pjjefferies/Balance_Bot/README.md

# Balance_Bots
 Balance Bot Development
 
 TBD - No really, TBD
