pjjefferies/Balance_Bot/Electronics/Balance Bot Electrical Connection (RP3 based).xlsx

Sheet: Matrix
Balance Bot Electrical Connections
 |  |  |  |  |  |  |  |  |  |  |  |  |  |  |  |  |  |  |  |  |  |  |  |  |  |  |  |  |  |  |  |  |  |  |  |  |  |  |  |  |  |  |  |  |  |  |  |  |  |  |  |  |  |  |  |  |  | M1A (OUT) | M1B (OUT)
Cable Asm. GND | Component | Compact Rechargeable Power Bank (1) | 18650 x 2 Battery Cells, Switched (2) |  | Raspberry Pi (3) |  |  |  |  |  |  |  |  |  |  |  |  |  |  |  |  |  |  |  |  |  |  | Regulator, DROK Mini Voltage Reducer DC 4.5-24 V Step Down Converter Board 3 A - #1 (4) |  |  |  | Regulator, DROK Mini Voltage Reducer DC 4.5-24 V Step Down Converter Board 3 A - #1 (5) |  |  |  | Middle Shelf +3.3 Volt Rail (17) |  |  |  |  |  | Middle Shelf GND Rail (18) |  |  |  |  |  |  |  |  |  | MDD3A Motor Controller - Wheels (6)
+3.3 V +5 V | Functional Pin | Power for Pi | +7.4 Volt | GND | +3.3 V | +5 V | Ground | GPIO14 (TXD) | Ground | USB-C | GPIO2 SDA PC | GPIO3 SDL PC | GPIO4 | GPIO17 | GPIO27 | GPIO22 | GPIO5 | GPIO6 | GPIO13 | GPIO19 | GPIO26 | GPIO21 | GPIO20 | GPIO16 | GPIO12 | GPIO25 | GPIO24 | Output + | Common Negative | Input + | Enable Port | Output + | Common Negative | Input + | Enable Port | N/A | N/A | N/A | N/A | N/A | N/A | N/A | N/A | N/A | N/A | N/A | N/A | N/A | N/A | N/A | N/A | VB+ | VB- | M1A (OUT) | M1B (OUT) | M2A (OUT) | M2B (OUT) | M1A (IN) | M1B (IN)
+7.4 V +6 V | Physical Pin | N/A | 1 | 2 | 1 | 4 | 6 | 8 | 9 | N/A | 3 | 5 | 7 | 11 | 13 | 15 | 29 | 31 | 33 | 35 | 37 | 40 | 38 | 36 | 32 | 22 | 18 | 1 | 2 | 3 | 4 | 1 | 2 | 3 | 4 | 1 | 2 | 3 | 4 | 5 | 6 | 1 | 2 | 3 | 4 | 5 | 6 | 7 | 8 | 9 | 10 | Green Left | Green Right | Black Left Left | Black Left Right | Black Right Left | Black Right Right | 1 | 2
Signals Out Signals In | Connector Type | USB-C | Bare Wire | Bare Wire | □.64 mm Pin | □.64 mm Pin | □.64 mm Pin | □.64 mm Pin | □.64 mm Pin | USB-C | □.64 mm Pin | □.64 mm Pin | □.64 mm Pin | □.64 mm Pin | □.64 mm Pin | □.64 mm Pin | □.64 mm Pin | □.64 mm Pin | □.64 mm Pin | □.64 mm Pin | □.64 mm Pin | □.64 mm Pin | □.64 mm Pin | □.64 mm Pin | □.64 mm Pin | □.64 mm Pin | □.64 mm Pin | PCB Hole | PCB Hole | PCB Hole | PCB Hole | PCB Hole | PCB Hole | PCB Hole | PCB Hole | □.64 mm Pin | □.64 mm Pin | □.64 mm Pin | □.64 mm Pin | □.64 mm Pin | □.64 mm Pin | □.64 mm Pin | □.64 mm Pin | □.64 mm Pin | □.64 mm Pin | □.64 mm Pin | □.64 mm Pin | □.64 mm Pin | □.64 mm Pin | □.64 mm Pin | □.64 mm Pin |  |  |  |  |  |  | □.64 mm Pin | □.64 mm Pin
Priorities 1: For initial movement 4. Arm Movement 2: For Wheel Sensor 5. Arm Sensors 3. Sensor | Priority | Power for Electronics | Power for Motors | Power for Motors | Power for 5 Sensors | Power for Motor Power Relay | Ground for Motor Power Relay | Signal to Motor Power Relay | Ground for All | Power In | 9DOF Sensor | 9DOF Sensor | Left Wheel Fwd. | Left Wheel Rwd. | Right Wheel Fwd. | Right Wheel Rwd. | Left Arm Fwd. | Left Arm Rwd. | Right Arm Fwd. | Right Arm Rwd. | Left Wheel Encoder | Right Wheel Encoder | Left Arm Encoder | Right Arm Encoder | Enable Power to Wheels | Enable Power to Arms | Reset Sensor | +6 V Out to Wheel Motor Controller | GND from Mid. Shelf GND Rail | 7.4 V In from Batteries | Enable from Pi | +6 V Out to Wheel Motor Controller | GND from Mid. Shelf GND Rail | 7.4 V In from Batteries | Enable from Pi | +3.3 V From Raspbery Pi | 3.3 V to Left Arm Sensor | 3.3 V to Right Arm Sensor | +3.3 V to Lower Shelf +3.3 Volt Rail | +3.3 V Empty | +3.3 V Empty | Gnd to Pi | Gnd to 7.4 V Battery Pack | Gnd to Wheel Voltage Reg. | Gnd to Arm Voltage Reg. | Gnd to Wheel Motor Controler | Gnd to Arm Motor Controler | GND to Left Arm Sensor | GND to Right Arm Sensor | Gnd to Lower Shelf Gnd Rail | Gnd - Empty | +6 V in from Reg. | GND to Mid. Shelf Rail | +V Out to Left Wheel Motor Fwd. | +V Out to Left Wheel Motor Rwd. | +V Out to Right Wheel Motor Fwd. | +V Out to Right Wheel Motor Rwd. | +V Level in For Left Wheel Motor Speed Fwd. | +V Level in For Left Wheel Motor Speed Rwd.
~~USB Cord + USB Cord with Switch~~ | 1A
~~2-Batt. Pack to Both Volt. Reg. (+7.4 V)~~ | 1A / 4
~~2-Batt. Pack to Middle Shelf GND Rail (GND)~~ | 1A / 4
RaspPi +3.3 V to +3.3 V Rail | 1A
RaspPI GND to Middle Shelf GND Rail | 1A
RaspPI Signal to Left Wheel FWD | 1A
RaspPI Signal to Left Wheel RWD | 1A
RaspPi Signal to Enable Wheel Motors | 1A
3.3 V from Middle Shelf Rail to Lower Shelf Rail | 1A
~~+6 V from Reg. (4) to Wheel Motor Controller~~ | 1A
~~GND from Middle Shelf Rail to Wheel Voltage Regulator~~ | 1A
~~Middle Shelf GND Rail to Wheel Motor Controller~~ | 1A
Middle Shelf GND Rail to Lower Shelf GND Rail | 1A
~~Wheel Motor Controller to Left Wheel Motor - FWD~~ | 1A
~~Wheel Motor Controller to Left Wheel Motor - RWD~~ | 1A
RaspPI Signal to Right Wheel FWD | 1B
RaspPI Signal to Right Wheel RWD | 1B
~~Wheel Motor Controller to Right Wheel Motor - FWD~~ | 1B
~~Wheel Motor Controller to Right Wheel Motor - RWD~~ | 1B
Left Wheel Encoder to RaspPi | 2
Right Wheel Encoder to RaspPi | 2
+3.3 V Lower Shelf Rail to Left Wheel Rotation Sensor | 2
GND Lower Shelf Rail to Left Wheel Rotation Sensor | 2
+3.3 V Lower Shelf Rail to Right Wheel Rotation Sensor | 2
GND Lower Shelf Rail to Right Wheel Rotation Sensor | 2
RaspPi i2C SDA to BNO055 Sensor | 3
RaspPi i2C SDL/SCL to BNO055 Sensor | 3
RaspPi Signal to BNO055 Sensor Reset | 3
+3.3 V Lower Shelf Rail to BNO055 Sensor | 3
GND Lower Shelf Rail to BNO055 Sensor | 3
RaspPI Signal to Left Arm FWD | 4
RaspPI Signal to Left Arm RWD | 4
RaspPI Signal to Right Arm FWD | 4
RaspPI Signal to Right Arm RWD | 4
RaspPi Signal to Enable Arm Motors | 4
+6 V from Reg. (5) to Arm Motor Controller | 4
GND from Middle Shelf Rail to Arm Voltage Regulator | 4
Middle Shelf GND Rail to Arm Motor Controller | 4
Middle Shelf GND Rail to Right Arm Sensor | 4
Arm Motor Controller to Left Arm Motor - FWD | 4
Arm Motor Controller to Left Arm Motor - RWD | 4
Arm Motor Controller to Right Arm Motor - FWD | 4
Arm Motor Controller to Right Arm Motor - RWD | 4
Left Arm Encoder to RaspPi | 5
Right Arm Encoder to RaspPi | 5
+3.3 V from Middle Shelf Rail to Left Arm Sensor | 5
+3.3 V from Middle Shelf Rail to Right Arm Sensor | 5
Middle Shelf GND Rail to Left Arm Sensor | 5

Sheet: Modules-Pinouts
Wiring instructions:
1, VCC positive power supply 3.3-5V
2, GND power supply is negative
3, DO TTL switching signal output
4, AO this module does not work

Sheet: Wire Types
Voltage (V) | Voltage Drop (%) | Voltage Drop (V) / Length | Current (A) | Length (mm) | Length (ft) | Voltage Drop / 100 ft | AWG
7.4 | 1% | 0.074 | 3 | 200 | 0.656167979 | 11.2776 | 22
6 | 1% | 0.06 | 1.5 | 200 | 0.656167979 | 9.144 | 24
3.3 | 1% | 1% | 1 | 200 | 0.656167979 | 1.524 | 18
3.3 | 1% | 1% | 0.120 | 200 | 0.656167979 | 1.524 | 28
 |  |  |  |  |  |  |  |  | Wrapped Wire I have in Red, Green, Black: 20 AWG (7/28-7 strands of 28 gauge wire)
 |  |  |  |  |  |  |  |  | Cables with Connectors for Header Pins: 28 AWG (7/36)
AWG Gauge | Solid Dia. (mm) | Solid Area (mm^2) |  |  | 7 Strands Area (mm^2) |  |  | 7 Strands Area (mm^2) | Cables with Male Pins for Breadboard Wiring: 30 or 28 AWG (7/36 or 7/38)
42 | 0.06 | 0.003
40 | 0.08 | 0.005 |  |  |  |  |  | 0.03507252965
38 | 0.10 | 0.008 |  |  |  |  |  | 0.05576750658
36 | 0.13 | 0.013 |  |  |  |  |  | 0.08867380884
34 | 0.16 | 0.020
32 | 0.20 | 0.032
30 | 0.25 | 0.051
28 | 0.32 | 0.081 |  |  |  |  |  | 0.5668287995
26 | 0.40 | 0.129
24 | 0.51 | 0.205
22 | 0.64 | 0.326
20 | 0.81 | 0.518
18 | 1.02 | 0.823
16 | 1.29 | 1.309
14 | 1.63 | 2.081
12 | 2.05 | 3.309

Sheet: Matrix-old
Balance Bot Electrical Connections
 |  |  |  | Component | Compact Rechargeable Power Bank (1) | 18650 x 2 Battery Cells, Switched (2) |  | Raspberry Pi (3) |  |  |  |  |  |  |  |  |  |  |  |  |  |  |  |  | Regulator, DROK Mini Voltage Reducer DC 4.5-24 V Step Down Converter Board 3 A - #1 (4) |  |  |  | Regulator, DROK Mini Voltage Reducer DC 4.5-24 V Step Down Converter Board 3 A - #1 (5) |  |  |  | Middle Shelf +3.3 Volt Rail (17) |  |  |  |  |  | Middle Shelf GND Rail (18) |  |  |  |  |  |  |  |  |  | MDD3A Motor Controller - Wheels (6) |  |  |  |  |  |  |  |  |  | MDD3A Motor Controller - Arms (7)
 | · Short Cable with Switch · X mm USB-C Cable |  |  | Functional Pin | Power for Pi | +7.4 Volt | GND | +3.3 V | Ground | USB-C | GPIO4 | GPIO17 | GPIO27 | GPIO22 | GPIO5 | GPIO6 | GPIO13 | GPIO19 | GPIO26 | GPIO21 | GPIO20 | GPIO16 | GPIO12 | GPIO25 | Output + | Common Negative | Input + | Enable Port | Output + | Common Negative | Input + | Enable Port | N/A | N/A | N/A | N/A | N/A | N/A | N/A | N/A | N/A | N/A | N/A | N/A | N/A | N/A | N/A | N/A | VB+ | VB- | M1A-IN | M1B-IN | M2A-IN | M2B-IN | M1A-OUT | M1B-OUT | M2A-OUT | M2B-OUT | VB+
 |  |  |  | Physical Pin | N/A | 1 | 2 | 1 | 9 | N/A | 7 | 11 | 13 | 15 | 29 | 31 | 33 | 35 | 37 | 40 | 38 | 36 | 32 | 22 | 1 | 2 | 3 | 4 | 1 | 2 | 3 | 4 | 1 | 2 | 3 | 4 | 5 | 6 | 1 | 2 | 3 | 4 | 5 | 6 | 7 | 8 | 9 | 10 | Green Left | Green Right | Black Left Left | Black Left Right | Black Right Left | Black Right Right | 1 | 2 | 5 | 6 | Green Left
 |  |  |  | Connector Type | USB-C | Bare Wire | Bare Wire | □.64 mm Pin | □.64 mm Pin | USB-C | □.64 mm Pin | □.64 mm Pin | □.64 mm Pin | □.64 mm Pin | □.64 mm Pin | □.64 mm Pin | □.64 mm Pin | □.64 mm Pin | □.64 mm Pin | □.64 mm Pin | □.64 mm Pin | □.64 mm Pin | □.64 mm Pin | □.64 mm Pin | PCB Hole | PCB Hole | PCB Hole | PCB Hole | PCB Hole | PCB Hole | PCB Hole | PCB Hole | □.64 mm Pin | □.64 mm Pin | □.64 mm Pin | □.64 mm Pin | □.64 mm Pin | □.64 mm Pin | □.64 mm Pin | □.64 mm Pin | □.64 mm Pin | □.64 mm Pin | □.64 mm Pin | □.64 mm Pin | □.64 mm Pin | □.64 mm Pin | □.64 mm Pin | □.64 mm Pin |  |  |  |  |  |  | □.64 mm Pin | □.64 mm Pin | □.64 mm Pin | □.64 mm Pin
Component | Functional Pin | Physical Pin | Connector Type | Function | Power for Electronics | Power for Motors | Power for Motors | Power for 5 Sensors | Ground for All | Power In | Left Wheel Fwd. | Left Wheel Rwd. | Right Wheel Fwd. | Right Wheel Rwd. | Left Arm Fwd. | Left Arm Rwd. | Right Arm Fwd. | Right Arm Rwd. | Left Wheel Encoder | Right Wheel Encoder | Left Arm Encoder | Right Arm Encoder | Enable Power to Wheels | Enable Power to Arms | +6 V Out to Wheel Motor Controller | GND from Mid. Shelf GND Rail | 7.4 V In from Batteries | Enable from Pi | +6 V Out to Wheel Motor Controller | GND from Mid. Shelf GND Rail | 7.4 V In from Batteries | Enable from Pi | 3.3 V to Left Arm Sensor | 3.3 V to Right Arm Sensor | +3.3 V to Lower Shelf +3.3 Volt Rail | +3.3 V Empty | +3.3 V Empty | +3.3 V Empty | Gnd to Pi | Gnd to 7.4 V Battery Pack | Gnd to Wheel Voltage Reg. | Gnd to Arm Voltage Reg. | Gnd to Wheel Motor Controler | Gnd to Arm Motor Controler | GND to Left Arm Sensor | GND to Right Arm Sensor | Gnd to Lower Shelf Gnd Rail | Gnd - Empty | +6 V in from Reg. | GND to Mid. Shelf Rail | +V Out to Left Wheel Motor Fwd. | +V Out to Left Wheel Motor Rwd. | +V Out to Right Wheel Motor Fwd. | +V Out to Right Wheel Motor Rwd. | +V Level in For Left Wheel Motor Speed Fwd. | +V Level in For Left Wheel Motor Speed Rwd. | +V Level in For Right Wheel Motor Speed Fwd. | +V Level in For Right Wheel Motor Speed Rwd. | +6 V in from Reg.
Compact Rechargeable Power Bank (1) | Power for Pi | N/A | USB-C | Power for Electronics
18650 x 2 Battery Cells, Switched (2) | Power for Pi | 1 | Bare Wire | Power for Motors
 |  | 2 | Bare Wire | Power for Motors
Raspberry Pi (3) | +3.3 V | 1 | □.64 mm Pin | Power for 5 Sensors
 | Ground | 9 | □.64 mm Pin | Ground for All
 | USB-C | N/A | USB-C | Power In | ~100 mm USB-C M-F Cord With Switch X mm USB-C M-M Cord
 | GPIO4 | 7 | □.64 mm Pin | Left Wheel Fwd.
 | GPIO17 | 11 | □.64 mm Pin | Left Wheel Rwd.
 | GPIO27 | 13 | □.64 mm Pin | Right Wheel Fwd.
 | GPIO22 | 15 | □.64 mm Pin | Right Wheel Rwd.
 | GPIO5 | 29 | □.64 mm Pin | Left Arm Fwd.
 | GPIO6 | 31 | □.64 mm Pin | Left Arm Rwd.
 | GPIO13 | 33 | □.64 mm Pin | Right Arm Fwd.
 | GPIO19 | 35 | □.64 mm Pin | Right Arm Rwd.
 | GPIO26 | 37 | □.64 mm Pin | Left Wheel Encoder
 | GPIO21 | 40 | □.64 mm Pin | Right Wheel Encoder
 | GPIO20 | 38 | □.64 mm Pin | Left Arm Encoder
 | GPIO16 | 36 | □.64 mm Pin | Right Arm Encoder
 | GPIO12 | 32 | □.64 mm Pin | Enable Power to Wheels
 | GPIO25 | 22 | □.64 mm Pin | Enable Power to Arms
Regulator, DROK Mini Voltage Reducer DC 4.5-24 V Step Down Converter Board 3 A - #1 (4) | Output + | 1 | PCB Hole | +6 V Out to Wheel Motor Controller
 | Common Negative | 2 | PCB Hole | GND from Mid. Shelf GND Rail
 | Input + | 3 | PCB Hole | 7.4 V In from Batteries |  | 20 AWG, Red, length: ~200 mm
 | Enable Port | 4 | PCB Hole | Enable from Pi
Regulator, DROK Mini Voltage Reducer DC 4.5-24 V Step Down Converter Board 3 A - #1 (5) | Output + | 1 | PCB Hole | +6 V Out to Wheel Motor Controller
 | Common Negative | 2 | PCB Hole | GND from Mid. Shelf GND Rail
 | Input + | 3 | PCB Hole | 7.4 V In from Batteries |  | 20 AWG, Red, Short jumper from 1st Reg.
 | Enable Port | 4 | PCB Hole | Enable from Pi
Middle Shelf +3.3 Volt Rail (17) | N/A | 1 | □.64 mm Pin | 3.3 V to Left Arm Sensor
 | N/A | 2 | □.64 mm Pin | 3.3 V to Right Arm Sensor
 | N/A | 3 | □.64 mm Pin | +3.3 V to Lower Shelf +3.3 Volt Rail
 | N/A | 4 | □.64 mm Pin | +3.3 V from Raspberry Pi |  |  |  | 20 AWG,
 | N/A | 5 | □.64 mm Pin | +3.3 V Empty
 | N/A | 6 | □.64 mm Pin | +3.3 V Empty
Middle Shelf GND Rail (18) | N/A | 1 | □.64 mm Pin | Gnd to Pi |  |  |  |  | 20 AWG, Black,
 | N/A | 2 | □.64 mm Pin | Gnd to 7.4 V Battery Pack |  |  | 20 AWG, Black, ~200 mm
 | N/A | 3 | □.64 mm Pin | Gnd to Wheel Voltage Reg.
 | N/A | 4 | □.64 mm Pin | Gnd to Arm Voltage Reg.
 | N/A | 5 | □.64 mm Pin | Gnd to Wheel Motor Controler
 | N/A | 6 | □.64 mm Pin | Gnd to Arm Motor Controler
 | N/A | 7 | □.64 mm Pin | GND to Left Arm Sensor
 | N/A | 8 | □.64 mm Pin | GND to Right Arm Sensor
 | N/A | 9 | □.64 mm Pin | Gnd to Lower Shelf Gnd Rail
 | N/A | 10 | □.64 mm Pin | Gnd - Empty
MDD3A Motor Controller - Wheels (6) | VB+ | Green Left |  | +6 V in from Reg.
 | VB- | Green Right |  | GND to Mid. Shelf Rail
 | M1A-IN | Black Left Left |  | +V Out to Left Wheel Motor Fwd.
 | M1B-IN | Black Left Right |  | +V Out to Left Wheel Motor Rwd.
 | M2A-IN | Black Right Left |  | +V Out to Right Wheel Motor Fwd.
 | M2B-IN | Black Right Right |  | +V Out to Right Wheel Motor Rwd.
 | M1A-OUT | 1 | □.64 mm Pin | +V Level in For Left Wheel Motor Speed Fwd. |  |  |  |  |  |  | Something here
 | M1B-OUT | 2 | □.64 mm Pin | +V Level in For Left Wheel Motor Speed Rwd. |  |  |  |  |  |  |  | Something here
 | M2A-OUT | 5 | □.64 mm Pin | +V Level in For Right Wheel Motor Speed Fwd. |  |  |  |  |  |  |  |  | Something here
 | M2B-OUT | 6 | □.64 mm Pin | +V Level in For Right Wheel Motor Speed Rwd. |  |  |  |  |  |  |  |  |  | Something here
MDD3A Motor Controller - Arms (7) | VB+ | Green Left |  | +6 V in from Reg.
 | VB- | Green Right |  | GND to Mid. Shelf Rail
 | M1A-IN | Black Left Left |  | +V Out to Left Arm Motor Front Up
 | M1B-IN | Black Left Right |  | +V Out to Left Arm Motor Front Down
 | M2A-IN | Black Right Left |  | +V Out to Right Arm Motor Front Up
 | M2B-IN | Black Right Right |  | +V Out to Right Arm Motor Front Down
 | M1A-OUT | 1 | □.64 mm Pin | +V Level in For Left Arm Motor Speed Front Up |  |  |  |  |  |  |  |  |  |  | Something here
 | M1B-OUT | 2 | □.64 mm Pin | +V Level in For Left Arm Motor Speed Front Down |  |  |  |  |  |  |  |  |  |  |  | Something here
 | M2A-OUT | 5 | □.64 mm Pin | +V Level in For Right Arm Motor Speed Front Up |  |  |  |  |  |  |  |  |  |  |  |  | Something here
 | M2B-OUT | 6 | □.64 mm Pin | +V Level in For Right Arm Motor Speed Front Down |  |  |  |  |  |  |  |  |  |  |  |  |  | Something here
Left Arm Motor (10) | Up Front | 1 | Soldier Tab | +Up to 6 V to Lift Arm Up
 | Down Front | 2 | Soldier Tab | +Up to 6 V to Lower Arm Down
Right Arm Motor (11) | Up Front | 1 | Soldier Tab | +Up to 6 V to Lift Arm Up
 | Down Front | 2 | Soldier Tab | +Up to 6 V to Lower Arm Down
Left Arm Rotation Sensor (14) | VCC | 1 | □.64 mm Pin | +3.3-5 V
 | GND | 2 | □.64 mm Pin | GND
 | D0 | 3 | □.64 mm Pin | TTL output
 | A0 | 4 | □.64 mm Pin | No Op.
Left Arm Rotation Sensor (15) | VCC | 1 | □.64 mm Pin | +3.3-5 V
 | GND | 2 | □.64 mm Pin | GND
 | D0 | 3 | □.64 mm Pin | TTL output
 | A0 | 4 | □.64 mm Pin | No Op.
Left Wheel Motor (8) | Up Front | 1 | Soldier Tab | +Up to 6 V to Lift Wheel Up
 | Down Front | 2 | Soldier Tab | +Up to 6 V to Lower Wheel Down
Right Wheel Motor (9) | Up Front | 1 | Soldier Tab | +Up to 6 V to Lift Wheel Up
 | Down Front | 2 | Soldier Tab | +Up to 6 V to Lower Wheel Down
Left Wheel Rotation Sensor (12) | VCC | 1 | □.64 mm Pin | +3.3-5 V
 | GND | 2 | □.64 mm Pin | GND
 | D0 | 3 | □.64 mm Pin | TTL output
 | A0 | 4 | □.64 mm Pin | No Op.
Left Wheel Rotation Sensor (13) | VCC | 1 | □.64 mm Pin | +3.3-5 V
 | GND | 2 | □.64 mm Pin | GND
 | D0 | 3 | □.64 mm Pin | TTL output
 | A0 | 4 | □.64 mm Pin | No Op.
BNO055 Adafruit Board (16) | Vin | 1-1 | PCB Hole | 3.3-5 V In
 | 3vo | 1-2 | PCB Hole | 3.3 V Out (up to 50 mA)
 | GND | 1-3 | PCB Hole | Common Ground
 | SDA | 1-4 | PCB Hole | I2C Data Line
 | SLC | 1-5 | PCB Hole | SLC Data Line
 | RST | 1-6 | PCB Hole | L-H Reset
 | PS0 | 2-1 | PCB Hole | Mode Change
 | PS1 | 2-2 | PCB Hole | Mode Change
 | INT | 2-3 | PCB Hole | Triggered Interrupt
 | ADR | 2-4 | PCB Hole | I2C Address Change
Lower Shelf +3.3 Volt Rail (19) | N/A | 1 | □.64 mm Pin | +3.3 V to Middle Shelf +3.3 Volt Rail
 | N/A | 2 | □.64 mm Pin | 3.3 V to Left Wheel Sensor
 | N/A | 3 | □.64 mm Pin | 3.3 V to Right Wheel Sensor
 | N/A | 4 | □.64 mm Pin | 3.3 V to BNO055 Sensor
 | N/A | 5 | □.64 mm Pin | +3.3 V Empty
 | N/A | 6 | □.64 mm Pin | +3.3 V Empty
 | N/A | 7 | □.64 mm Pin | +3.3 V Empty
 | N/A | 8 | □.64 mm Pin | +3.3 V Empty
Lower Shelf GND Rail (20) | N/A | 1 | □.64 mm Pin | GND from Middle Shelf Gnd Rail
 | N/A | 2 | □.64 mm Pin | GND to Left Wheel Sensor
 | N/A | 3 | □.64 mm Pin | GND to Right Wheel Sensor
 | N/A | 4 | □.64 mm Pin | GND to BNO055 Sensor
 | N/A | 5 | □.64 mm Pin | Gnd - Empty
 | N/A | 6 | □.64 mm Pin | Gnd - Empty
 | N/A | 7 | □.64 mm Pin | Gnd - Empty
 | N/A | 8 | □.64 mm Pin | Gnd - Empty
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
