pjjefferies/Balance_Bot/BOM/BOM, Balance Bot 001.xlsx

Sheet: Balance Bot BOM
 |  |  |  | Indented BOM Report |  |  |  |  |  |  |  | Date: ?
 |  |  |  | [Release]
Line# | Level |  |  | Part Desc | UOM | Drawing Page | Cost Ea. | Cost Ext. | Qty | Est. Qty | Weight (kg) | Ext. Weight
 | 0 |  |  | Robot, Balance Bot, 001 |  | 1
 | 1 |  |  | ASM, LOWER SHELF |  | 6 |  | $0.00 | 1 | 1
 |  | 2 |  | SHELF, LOWER |  | 5 |  | $0.00 | 1 | 1 |  | 0.000
 |  | 2 |  | ASM, BEARING, MOUNT |  | 16 |  | $0.00 | 2 | 2 |  | 0.000
 |  |  | 3 | BLOCK, BEARING SUPPORT |  | 16 |  | $0.00 | 2 | 4 |  | 0.000
 |  |  | 3 | BEARING, 12.7X28.575X7.9875 |  |  |  | $0.00 | 1 | 2 |  | 0.000
 |  |  | 3 | RETAINER, BEARING |  | 16 |  | $0.00 | 2 | 4 |  | 0.000
 |  |  | 3 | SCREW, HEX, M3X16 |  |  |  | $0.00 | 4 | 8 |  | 0.000
 |  |  | 3 | NUT, HEX, M3 |  |  |  | $0.00 | 4 | 8 |  | 0.000
 |  | 2 |  | SHAFT, 0.5 IN, X L |  |  |  | $0.00 | 2 | 2 |  | 0.000
 |  | 2 |  | ENCODER, 25 mm |  |  |  | $0.00 | 2 | 2 |  | 0.000
 |  | 2 |  | WHEEL, TT MOTOR, 65 mm X ? |  |  |  | $0.00 | 2 | 2 |  | 0.000
 |  | 2 |  | BRACKET, MOUNTING, L-SHAPED |  | 15 |  | $0.00 | 4 | 4 |  | 0.000
 |  | 2 |  | MOTOR, TT |  |  |  | $0.00 | 2 | 2 |  | 0.000
 |  | 2 |  | MODULE, IR ENCODER |  |  |  | $0.00 | 2 | 2 |  | 0.000
 |  | 2 |  | MODULE, SENSOR, ADAFRUIT, BN055 |  |  |  | $0.00 | 1 | 1 |  | 0.000
 |  | 2 |  | HEADER, PIN, 1X6 |  |  |  | $0.00 | 1 | 1 |  | 0.000
 |  | 2 |  | STANDOFF, M3X ? |  |  |  | $0.00 | 4 | 4 |  | 0.000
 |  | 2 |  | SCREW, M3X8 |  |  |  | $0.00 | 6 | 6 |  | 0.000
 |  | 2 |  | SCREW,M3X12 |  |  |  |  | 12 | 12
 |  | 2 |  | SCREW,M3X25 |  |  |  |  | 4 | 4
 |  | 2 |  | NUT, HEX, M3 |  |  |  |  | 14 | 14
 | 1 |  |  | ASM, MIDDLE SHELF |  | 7 |  | $0.00 | 1 | 1
 |  | 2 |  | SHELF, MIDDLE |  | 4 |  | $0.00 | 3 | 3 |  | 0.000
 |  | 2 |  | MODULE, MOTOR, XXX |  |  |  | $0.00 | 6 | 6 |  | 0.000
 |  | 2 |  | MODULE, RASPBERRY PI 4, MODEL B |  |  |  | $0.00 | 2 | 2 |  | 0.000
 |  |  | 3 | Main Control Module
 |  |  | 3 | Motor Control Module
 |  |  | 3 | Balance Module
 |  |  | 3 | Forward/Reverse Motion Module
 |  |  | 3 | Turning Module
 |  |  | 3 | Path Navigation Module
 |  |  | 3 | Receive Remote Signal Module
 |  |  | 3 | Display / Message Module
 |  |  | 3 | Object Detection Module
 |  |  | 3 | Mapping Module
 |  |  | 3 | Route Planning Module
 |  | 2 |  | ASM, BEARING, MOUNT |  | 16 |  | $0.00 | 2 | 2 |  | 0.000
 |  |  | 3 | BLOCK, BEARING SUPPORT |  | 16 |  | $0.00 | 2 | 4 |  | 0.000
 |  |  | 3 | BEARING, 12.7X28.575X7.9875 |  |  |  | $0.00 | 1 | 2 |  | 0.000
 |  |  | 3 | RETAINER, BEARING |  | 16 |  | $0.00 | 2 | 4 |  | 0.000
 |  |  | 3 | SCREW, HEX, M3X16 |  |  |  | $0.00 | 4 | 8
 |  |  | 3 | NUT, HEX, M3 |  |  |  | $0.00 | 4 | 8
 |  | 2 |  | ASM, ARM |  | 14 |  | $0.00 | 2 | 2
 |  |  | 3 | AXLE, ARM |  | 14 |  |  | 1 | 2
 |  |  | 3 | ARM |  | 14 |  |  | 1 | 1
 |  | 2 |  | ENCODER, 25 mm |  |  |  |  | 2 | 2
 |  | 2 |  | BRACKET, MOUNTING, L-SHAPED |  | 15 |  |  | 4 | 4
 |  | 2 |  | ENCODER, 25 mm |  |  |  |  | 2 | 2
 |  | 2 |  | MOTOR, TT, 99:1 GEAR RATIO |  |  |  |  | 2 | 2
 |  | 2 |  | MODULE, IR ENCODER |  |  |  |  | 2 | 2
 |  | 2 |  | STANDOFF, M3X ? |  |  |  | $0.00 | 12 | 12 |  | 0.000
 |  | 2 |  | SCREW, M3X8 |  |  |  | $0.00 | 14 | 14 |  | 0.000
 |  | 2 |  | SCREW,M3X12 |  |  |  |  | 20 | 20
 |  | 2 |  | SCREW,M3X25 |  |  |  |  | 4 | 4
 |  | 2 |  | NUT, HEX, M3 |  |  |  |  | 12 | 12
 | 1 |  |  | ASM, TOP SHELF |  | 8 |  | $0.00 | 1 | 1
 |  | 2 |  | SHELF, TOP |  | 2 |  | $0.00 | 1 | 1 |  | 0.000
 |  | 2 |  | BLOCK, LOCATING |  | 15 |  | $0.00 | 2 | 2 |  | 0.000
 |  | 2 |  | MODULE, POWER BANK |  |  |  | $0.00 | 1 | 1 |  | 0.000
 |  | 2 |  | RETAINER, POWER BANK |  | 15 |  | $0.00 | 1 | 1 |  | 0.000
 |  | 2 |  | HOLDER, BATTERY, 2X18650 |  |  |  | $0.00 | 1 | 1 |  | 0.000
 |  | 2 |  | BATTERY, 2X18650 |  |  |  | $0.00 | 2 | 2 |  | 0.000
 |  | 2 |  | SCREW, WOOD, #8x1/2" |  |  |  | $0.00 | 8 | 8 |  | 0.000
 |  | 2 |  | SCREW, FLAT HEAD, #8x6-8 |  |  |  | $0.00 | 4 | 4 |  | 0.000
 |  | 2 |  | NUT, Tee, #8 |  |  |  | $0.00 | 4 | 4 |  | 0.000
 | 1 |  |  | ASM, FRONT COVER |  | 13 |  | $0.00 | 1 | 1 |  | 0.000
 |  | 2 |  | COVER, FRONT |  | 9 |  |  | 1 | 1
 |  | 2 |  | SUPPORT, 9.375 x X 50 |  | 3 |  |  | 2 | 2
 |  | 2 |  | SUPPORT, 19.05 x X 75 |  | 3 |  |  | 4 | 4
 | 1 |  |  | ASM, SIDE COVER |  | 12 |  |  | 2 | 2
 |  | 2 |  | COVER, SIDE |  | 11 |  |  | 1 | 2
 |  | 2 |  | SUPPORT, 19.05 x X 50 |  | 3 |  |  | 4 | 8
 | 1 |  |  | COVER, BACK |  | 10 |  |  | 1 | 1
 | 2 |  |  | HINGES, ? |  |  |  |  | 2 | 2
 | 1 |  |  |  |  |  |  | $0.00 | 2 |  |  | 0.000
 |  | 2 |  |  |  |  |  | $0.00 | 2 |  |  | 0.000
 |  | 2 |  | Microcomputer, Raspberry Pi, 4 |  |  |  | $0.00 | 1 |  |  | 0.0000
 |  | 2

Sheet: Hardware
 | Fasteners
 | [Release]
Line# | Part Desc | Qty | Weight (kg)
 | HINGES, ? | 2
 | NUT, Tee, #8 | 4
 | SCREW, FLAT HEAD, #8x6-8 | 4
 | SCREW, WOOD, #8x1/2" | 8
 | NUT, HEX, M3 | 42
 | SCREW, M3X8 | 20
 | SCREW, M3X12 | 32
 | SCREW, M3X16 | 16
 | SCREW, M3X25 | 8
 | STANDOFF, M3X ? | 16

Sheet: BOM Report (2)
 |  |  | Indented BOM - Remote Control, Nunchuk |  |  |  |  |  |  | Date: ?
 |  |  |  |  |  |  |  |  |  |  | 60 | 5
 |  |  | [Release]
Line# | Level |  | Part Desc | UOM | Cost Ea. | Cost Ext. | Qty | Ext. Length | Weight (kg) | Ext. Weight | 180.8125 | 15.06770833
 | 0 |  | Module, Remote Control, Nunchuk | EA |  | $0.00 |  |  |  |  | 15.59375 | 15.59375
 | 1 |  | Box, Base, TBD | EA |  | $0.00 | 1 |  |  |  | 15.59375 | 31.1875
 | 1 |  | Board, Circuit, Mounting | EA |  | $0.00 | 1
 | 1 |  | Microcontroller, Microbit | EA |  | $0.00 | 1 |  |  |  | 15 | 46.1875
 | 1 |  | Microbit Sensor Breakout Board | EA | $10.00 | $10.00 | 1 |  |  | 0.000 | 15 | 61.1875
 | 1 |  | Standoffs | EA |  | $0.00 | 4 |  |  |  | 15 | 76.1875
 | 1 |  | Screws, X | EA |  | $0.00 | 8 |  |  | 0.000 | 13 | 89.1875
 | 1 |  | Wii Adapter Module | EA | $5.58 | $5.58 | 1 |  |  |  | 13 | 102.1875
 | 1 |  | Connector, 4-Pin Standoff | EA | incl. |  | 1 |  |  |  | 11.5 | 113.6875 | 52.5
 | 1 |  | Wire, Pin to Circuit Board | EA |  | $0.00 | 4 |  |  | 0.000 | 11.5 | 11.5
 | 1 |  | Clip, Battery Mounting | EA |  | $0.00 | 1 |  |  |  | 11.25 | 22.75
 | 1 |  | Harness, Battery Connector | EA |  | $0.00 | 1 |  |  | 0.000 | 11.25 | 34
 |  | 2 | Connector, 9 Volt Battery with Pigtail | EA |  | $0.00 | 1 |  |  |  | 11.25 | 45.25
 |  | 2 | Connector, TBD | EA |  | $0.00 | 1 |  |  | 0.000 | 11.25 | 56.5
 | 1 |  | Box, Top | EA |  | $0.00 | 1 |  |  |  | 5.5 | #REF!
 | 1 |  | Clip, Box | EA |  | $0.00 | 1 |  |  | 0.000 | 5.125 | #REF!
 | 0 |  | Controller, Nunchuk | EA |  | $0.00 | 1
