pjjefferies/Balance_Bot/tests/programs/progtest_left50-2x20s_right50-2x20s.csv

# 1: motor_power_pin (GPIO# | int)
# 2: motor_pin_fwd (GPIO# | int)
# 3: motor_pin_rwd (GPIO# | int)
# 4: encoder_pin (GPIO# | int)
# 5: velocity (-1 | 1)
# 6: duration (float | seconds)
#
14 | 4 | 17 | 26 | 0.5 | 20
0 | 0 | 0 | 0 | 0 | 2
14 | 4 | 17 | 26 | -0.5 | 20
0 | 0 | 0 | 0 | 0 | 2
14 | 27 | 22 | 21 | 0.5 | 20
0 | 0 | 0 | 0 | 0 | 2
14 | 27 | 22 | 21 | -0.5 | 20
