pjjefferies/Balance_Bot/tests/programs/progtest_leftright-100-+100x10s.csv

# motor_power_pin (GPIO# | int) | motor_pin_fwd (GPIO# | int) | motor_pin_rwd (GPIO# | int)
# encoder_pin (GPIO# | int) | velocity (-1 | 1) | duration (float | seconds)
#
# Program to gather calibration data for wheele encoders
#
# Test Left Wheel Motor and Encoder First - -1 to +1 by 0.1 | 10 seconds each
14 | 4 | 17 | 26 | -1.0 | 10
0 | 0 | 0 | 0 | 0 | 1
14 | 4 | 17 | 26 | -0.9 | 10
0 | 0 | 0 | 0 | 0 | 1
14 | 4 | 17 | 26 | -0.8 | 10
0 | 0 | 0 | 0 | 0 | 1
14 | 4 | 17 | 26 | -0.7 | 10
0 | 0 | 0 | 0 | 0 | 1
14 | 4 | 17 | 26 | -0.6 | 10
0 | 0 | 0 | 0 | 0 | 1
14 | 4 | 17 | 26 | -0.5 | 10
0 | 0 | 0 | 0 | 0 | 1
14 | 4 | 17 | 26 | -0.4 | 10
0 | 0 | 0 | 0 | 0 | 1
14 | 4 | 17 | 26 | -0.3 | 10
0 | 0 | 0 | 0 | 0 | 1
14 | 4 | 17 | 26 | -0.2 | 10
0 | 0 | 0 | 0 | 0 | 1
14 | 4 | 17 | 26 | -0.1 | 10
0 | 0 | 0 | 0 | 0 | 1
14 | 4 | 17 | 26 | +0.1 | 10
0 | 0 | 0 | 0 | 0 | 1
14 | 4 | 17 | 26 | +0.2 | 10
0 | 0 | 0 | 0 | 0 | 1
14 | 4 | 17 | 26 | +0.3 | 10
0 | 0 | 0 | 0 | 0 | 1
14 | 4 | 17 | 26 | +0.4 | 10
0 | 0 | 0 | 0 | 0 | 1
14 | 4 | 17 | 26 | +0.5 | 10
0 | 0 | 0 | 0 | 0 | 1
14 | 4 | 17 | 26 | +0.6 | 10
0 | 0 | 0 | 0 | 0 | 1
14 | 4 | 17 | 26 | +0.7 | 10
0 | 0 | 0 | 0 | 0 | 1
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
