pjjefferies/Balance_Bot/tests/programs/progtest_left50-10s_right50-10s.csv

# motor_power_pin (GPIO# | int) | motor_pin_fwd (GPIO# | int) | motor_pin_rwd (GPIO# | int)
# encoder_pin (GPIO# | int) | velocity (-1 | 1) | duration (float | seconds)
14 | 4 | 17 | 26 | 0.5 | 2
0 | 0 | 0 | 0 | 0 | 2
14 | 27 | 22 | 21 | 0.5 | 2
