pjjefferies/Balance_Bot/(threads)

Thread 1 (2022-12-12):

Config file reference is absolute - will only work on Raspberry Pi with "pi" user. Will not work for simulations on WinPC.

pjjefferies, 2022-12-12:

pjjefferies, 2022-12-26:
Closed with balance_bot, tests made into packages in local .bbenv environment. System fooled to work as intended with soft links from .bbenv package locations linked to primary folders. Closed with commit 851ffd5ac533fc763c73128f3843f8d3dabbf5f3.

Closed 2022-12-26.

Thread 3 (2022-12-26):

Balance Bot wiring is ugly, especially bottom shelf

pjjefferies, 2022-12-26:
Consider making custom board for +V, GND and maybe signals to go through with harnesses from
