pjjefferies/Balance_Bot/drawings/Power Pack Attachment Parts.pdf

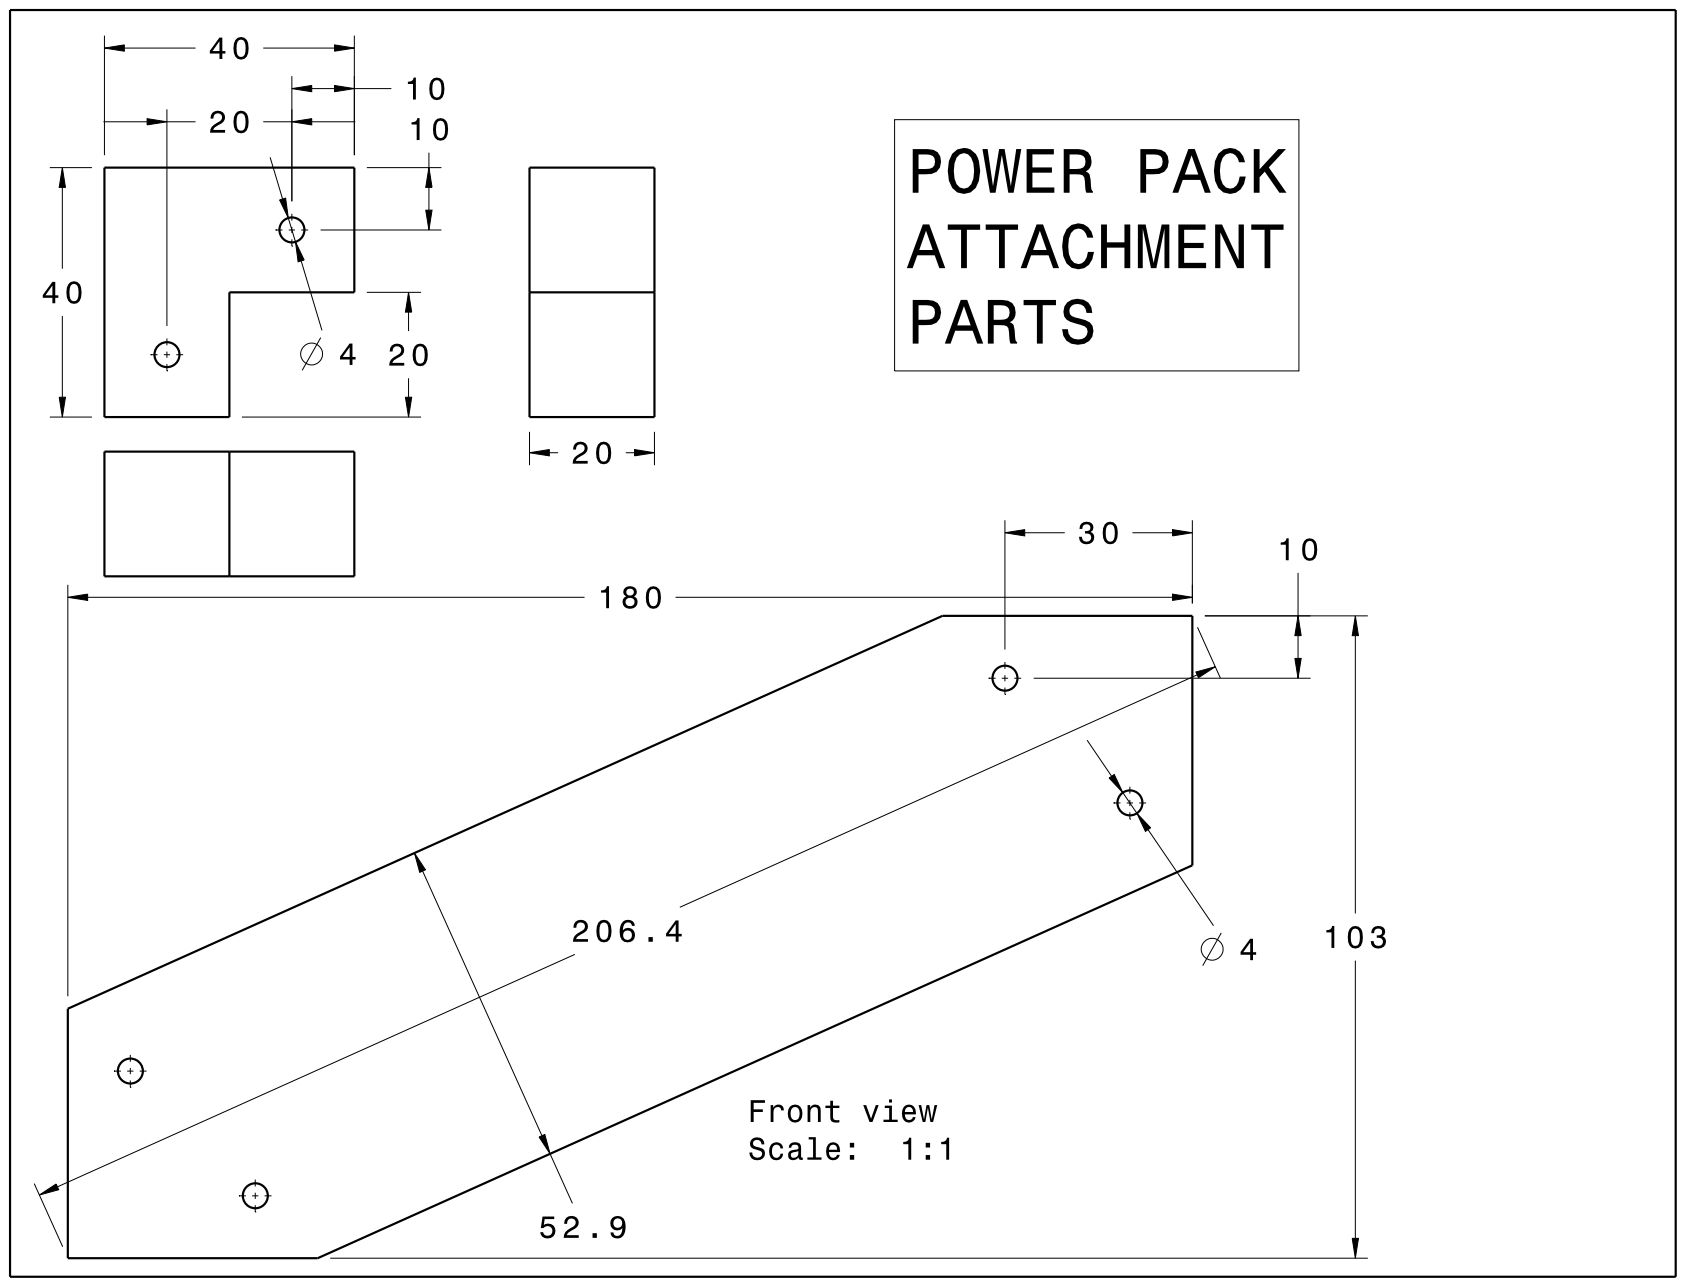
[picture p1: page 1]
