pjjefferies/Balance_Bot/drawings/Arm and Asm.pdf

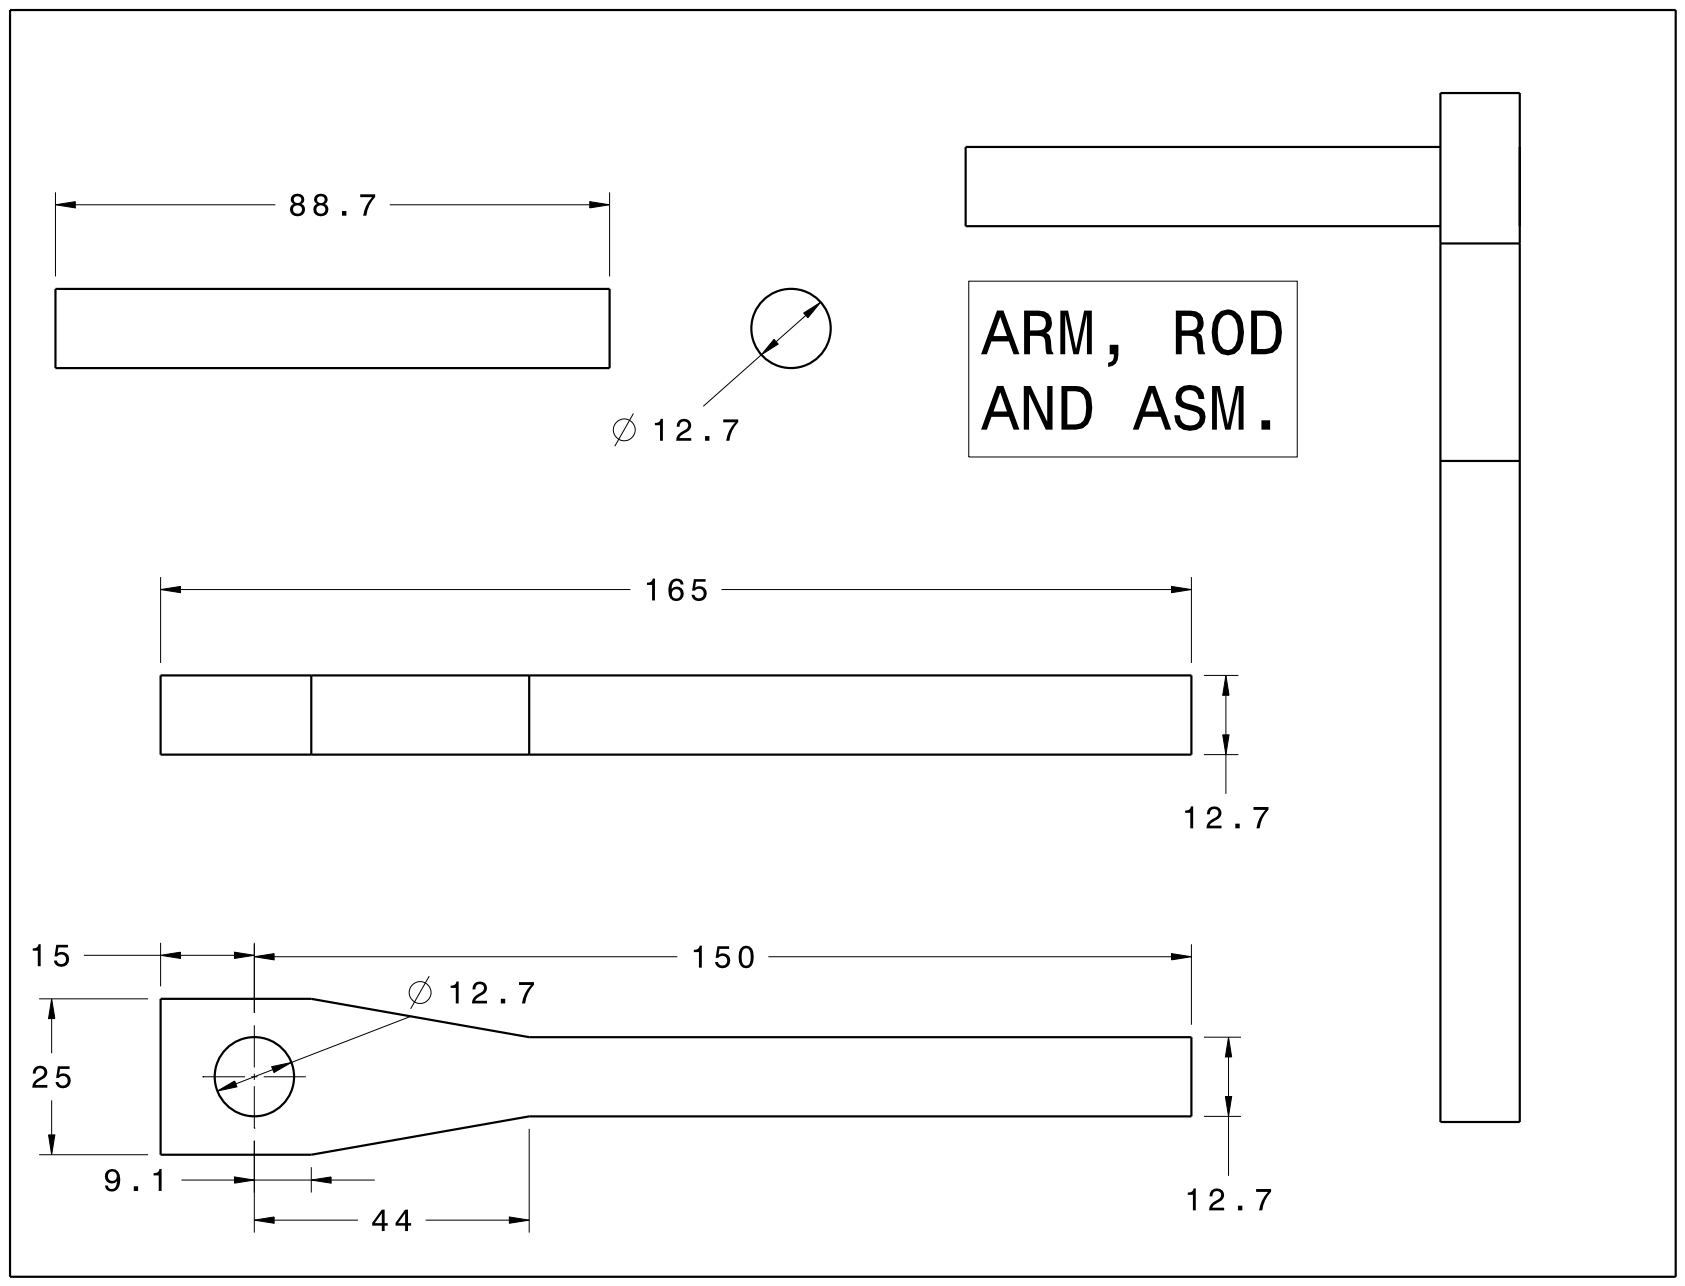
[picture p2: page 1]
