pjjefferies/Balance_Bot/drawings/Balance Bot.pdf

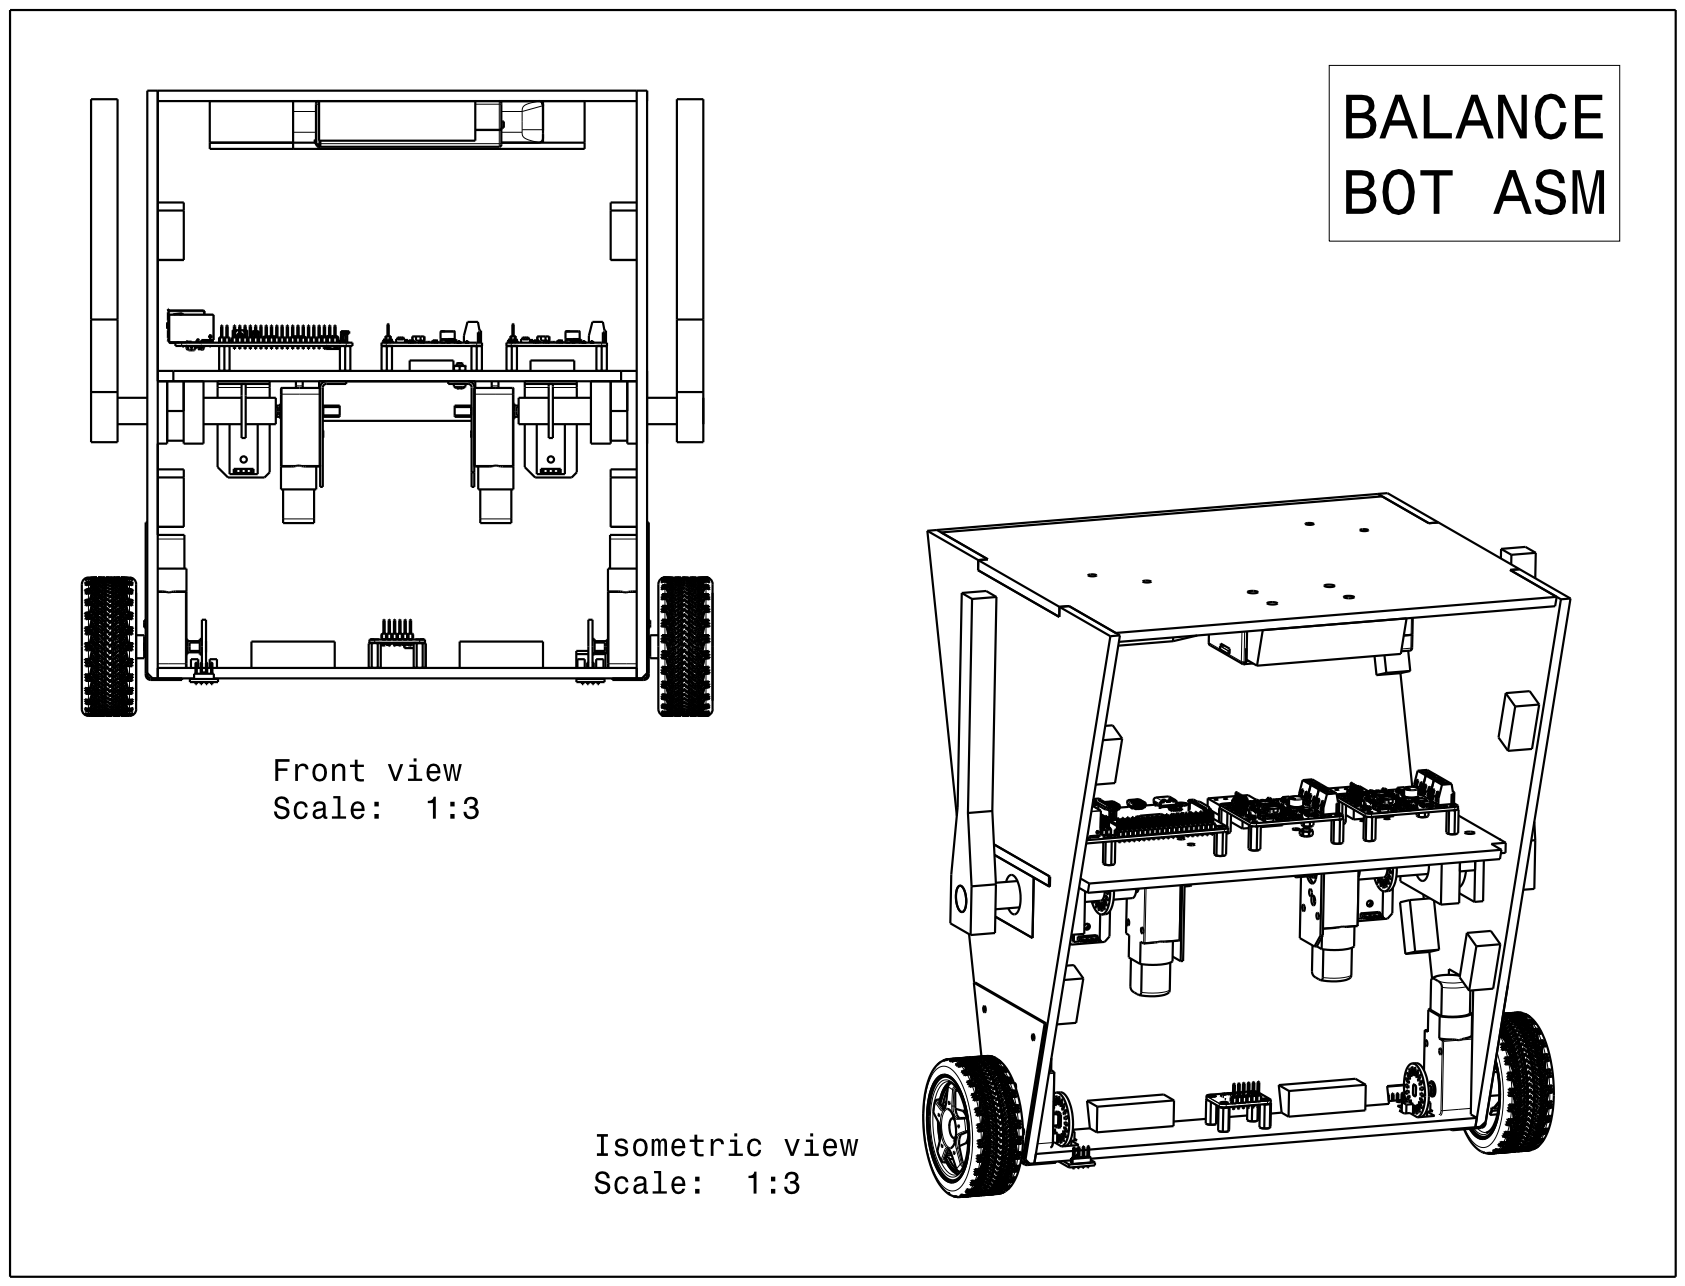
[picture p3: page 1]
