pjjefferies/Balance_Bot/drawings/Bearing Supoorts.pdf

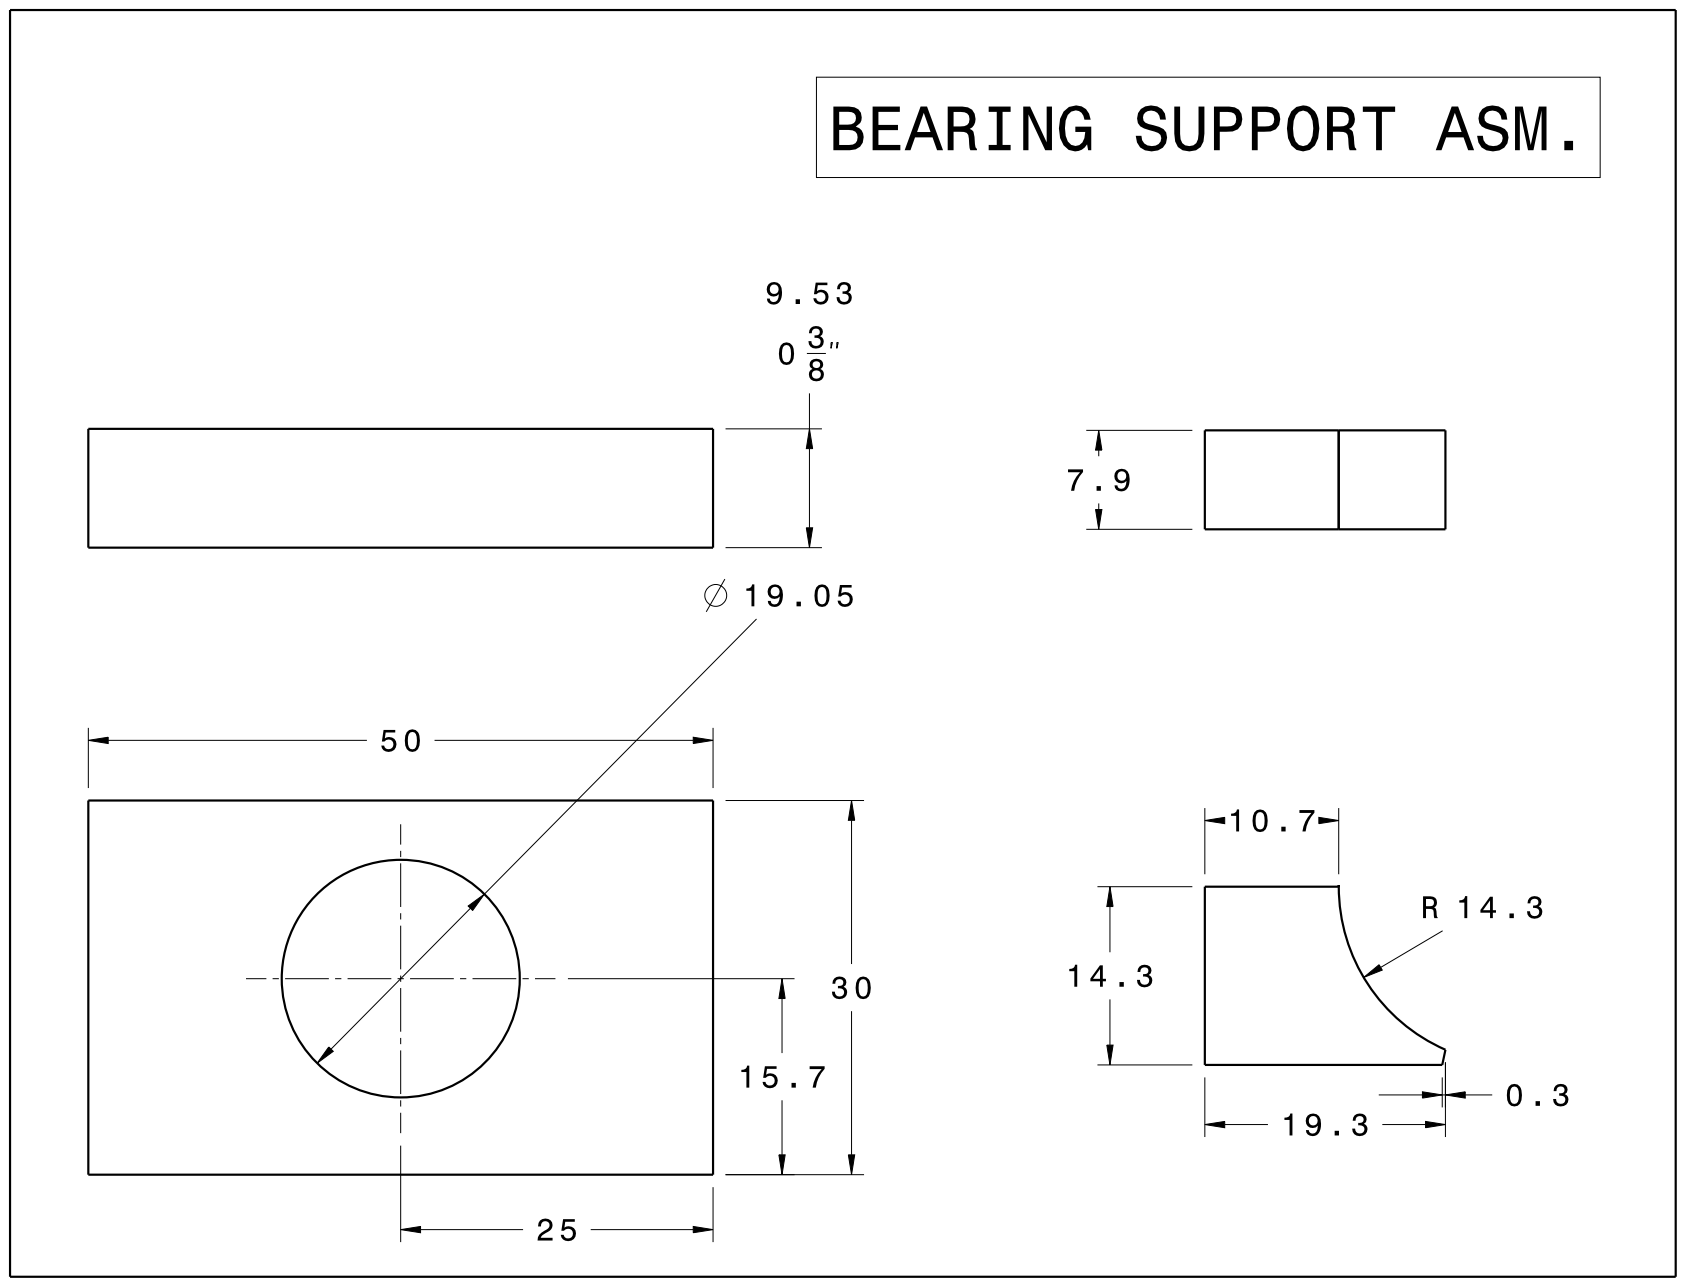
[picture p4: page 1]
