pjjefferies/Balance_Bot/drawings/Front and Back Panel.pdf

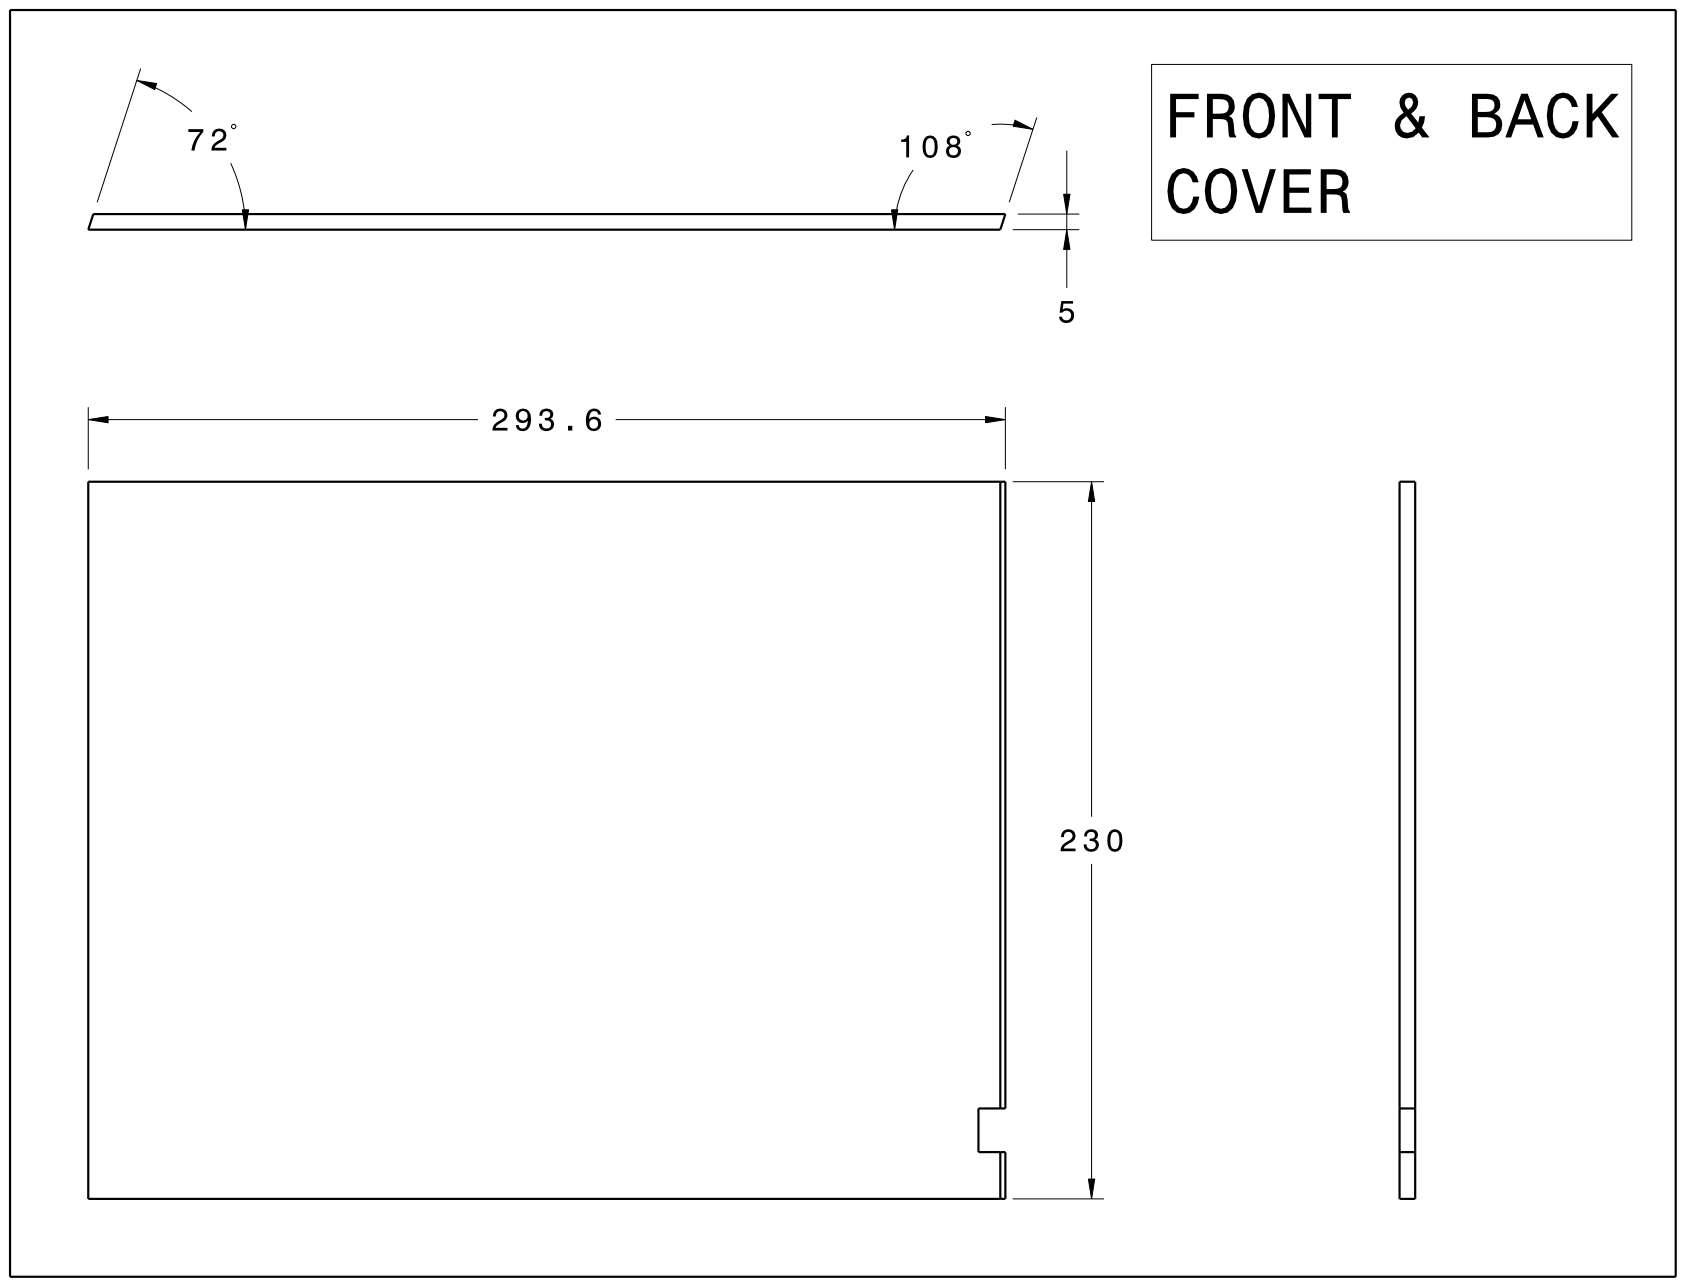
[picture p5: page 1]
