pjjefferies/Balance_Bot/drawings/Lower Shelf Asm.pdf

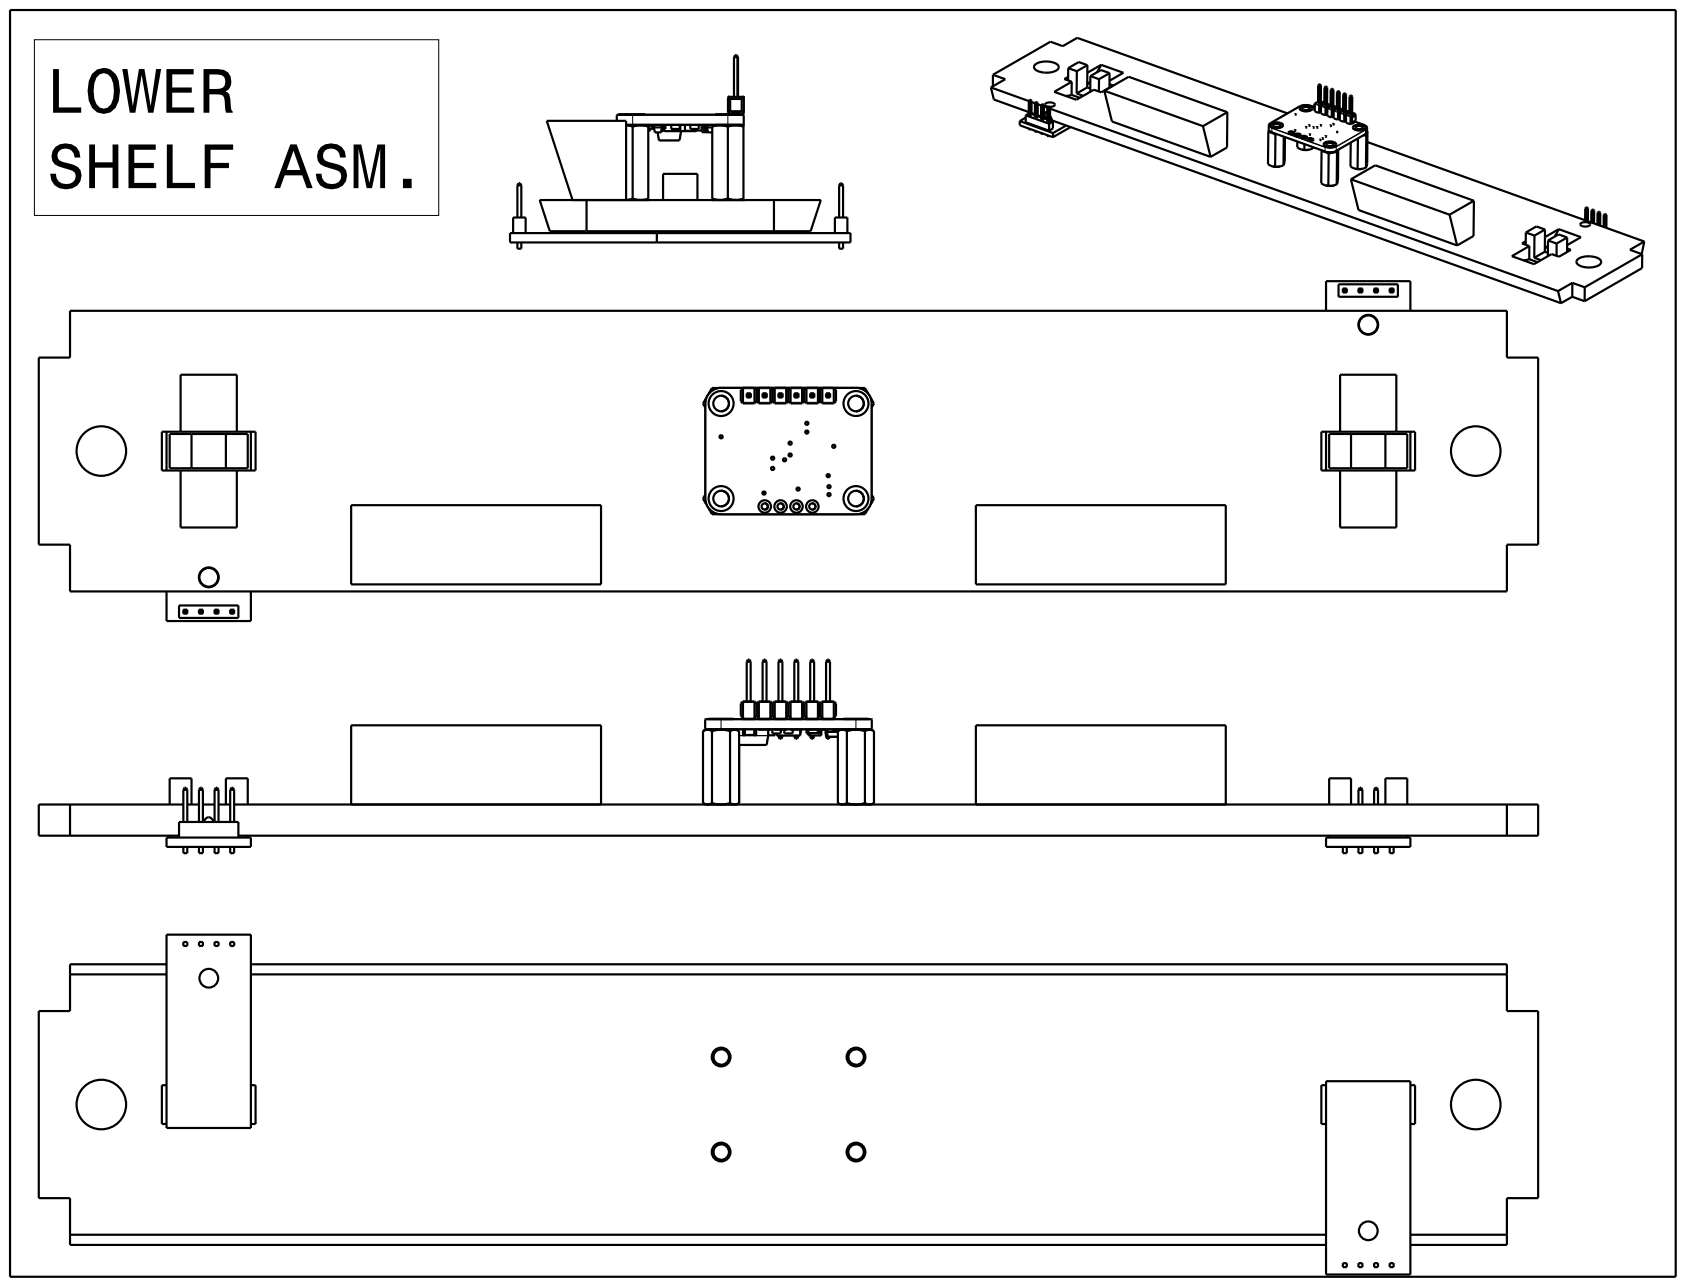
[picture p6: page 1]
