pjjefferies/Balance_Bot/drawings/Lower Shelf.pdf

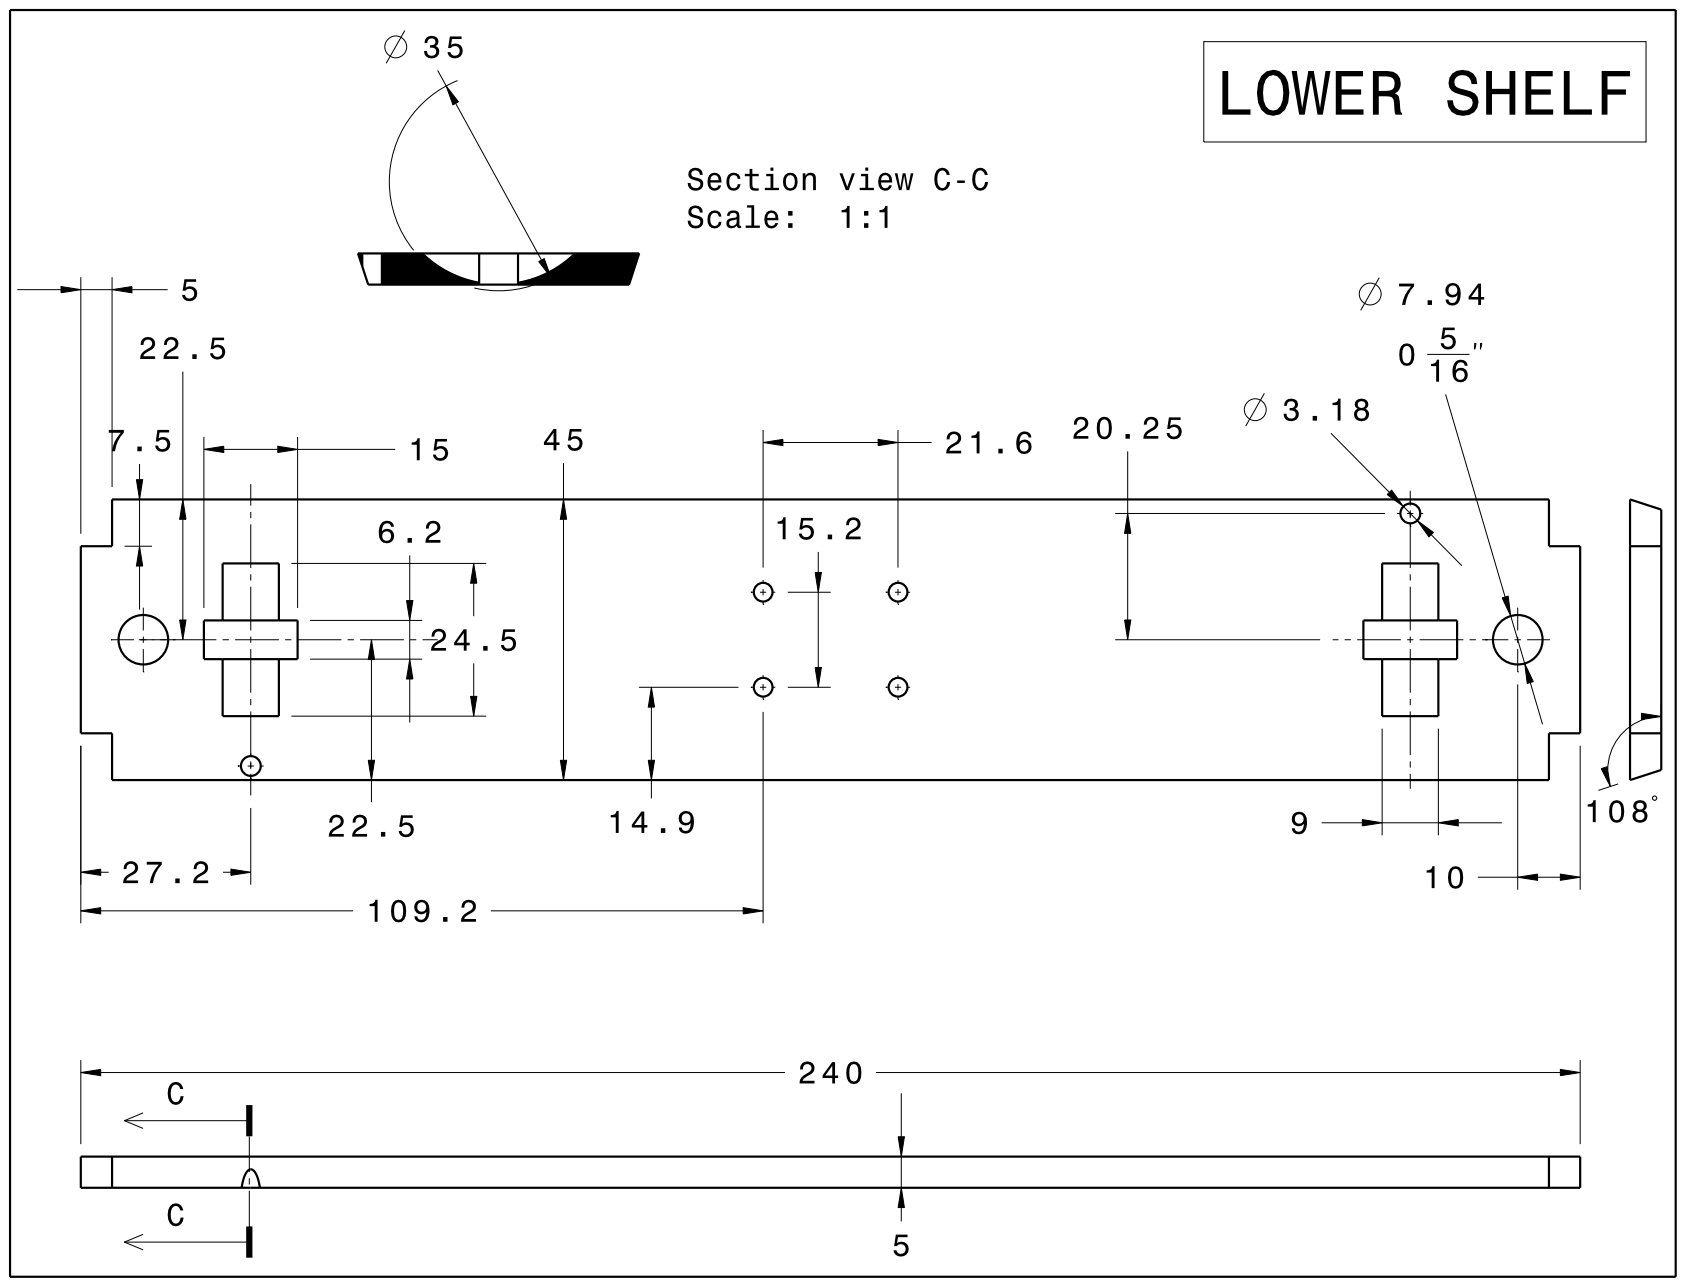
[picture p7: page 1]
