pjjefferies/Balance_Bot/drawings/Middle Shelf Asm.pdf

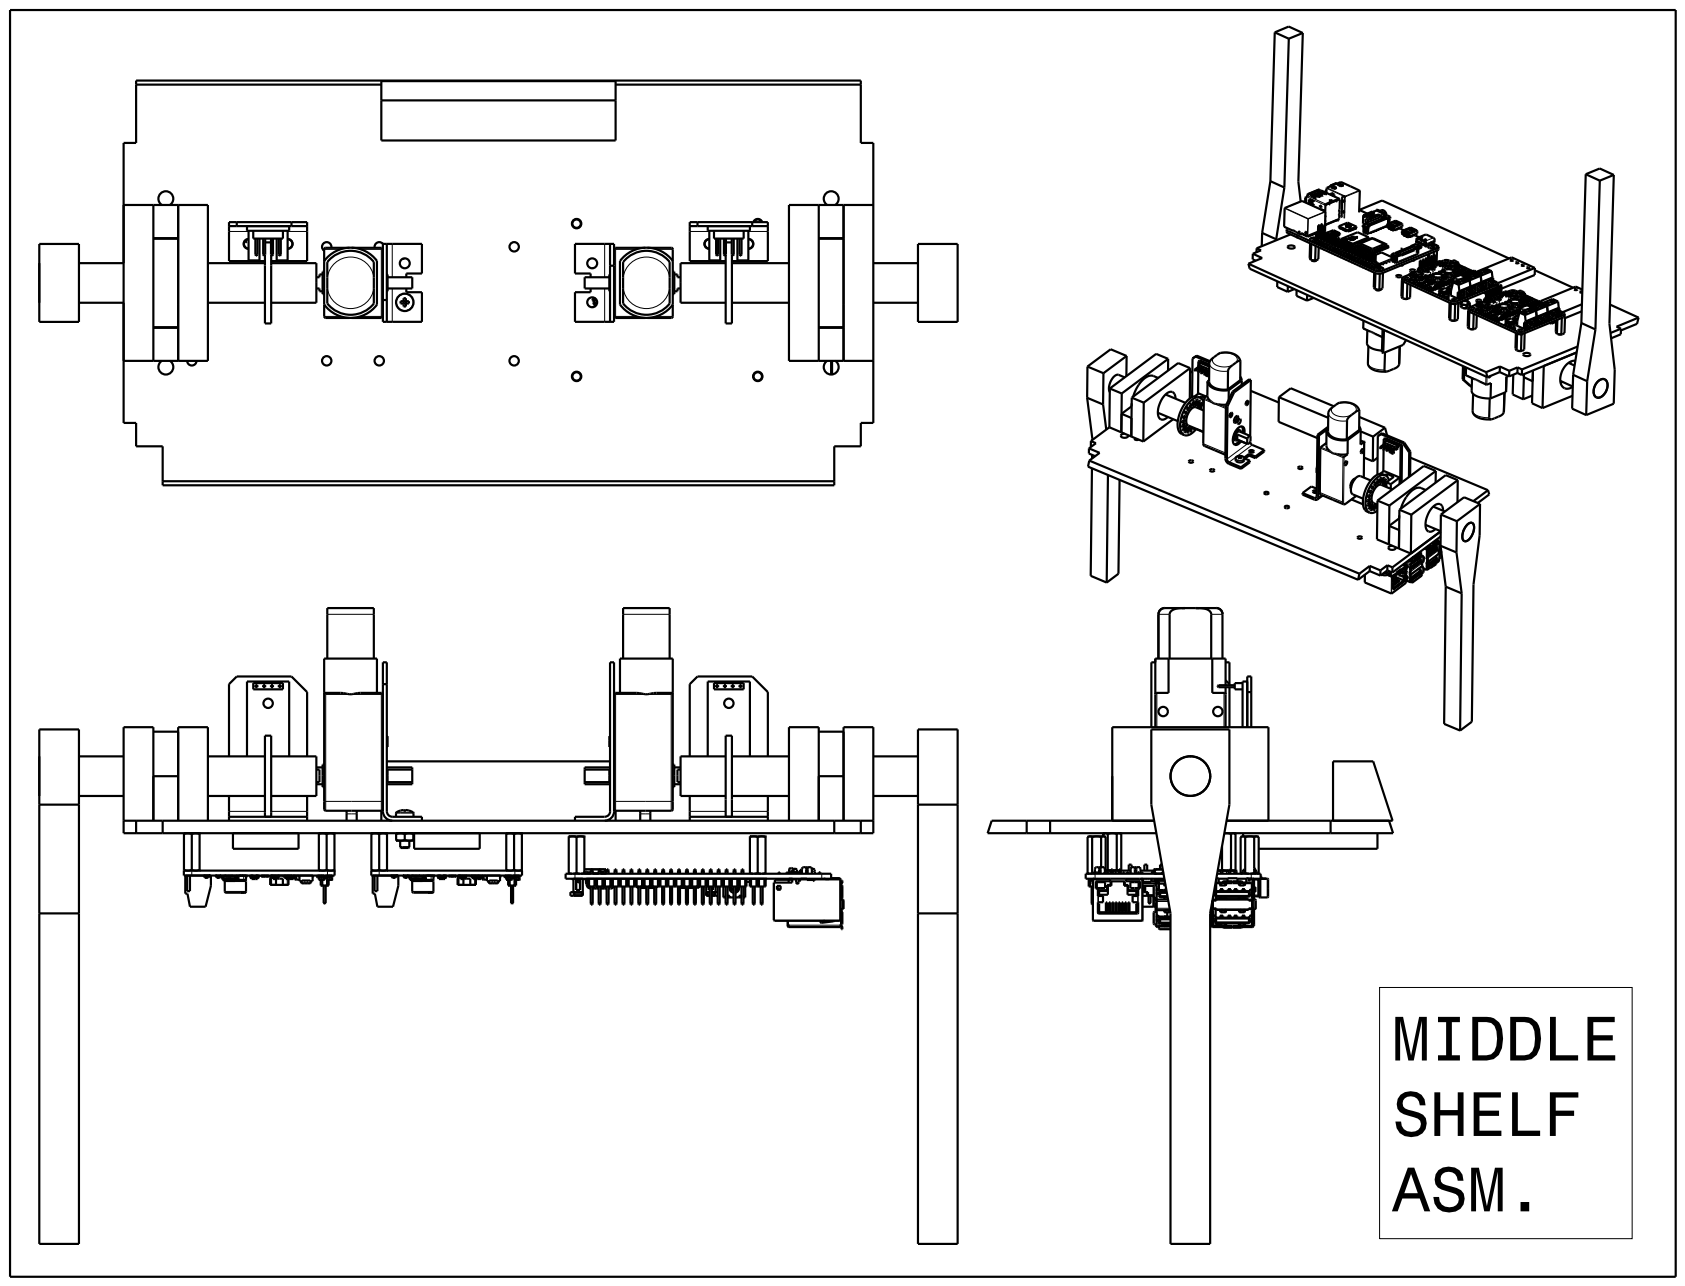
[picture p8: page 1]
