pjjefferies/Balance_Bot/drawings/Middle Shelf.pdf

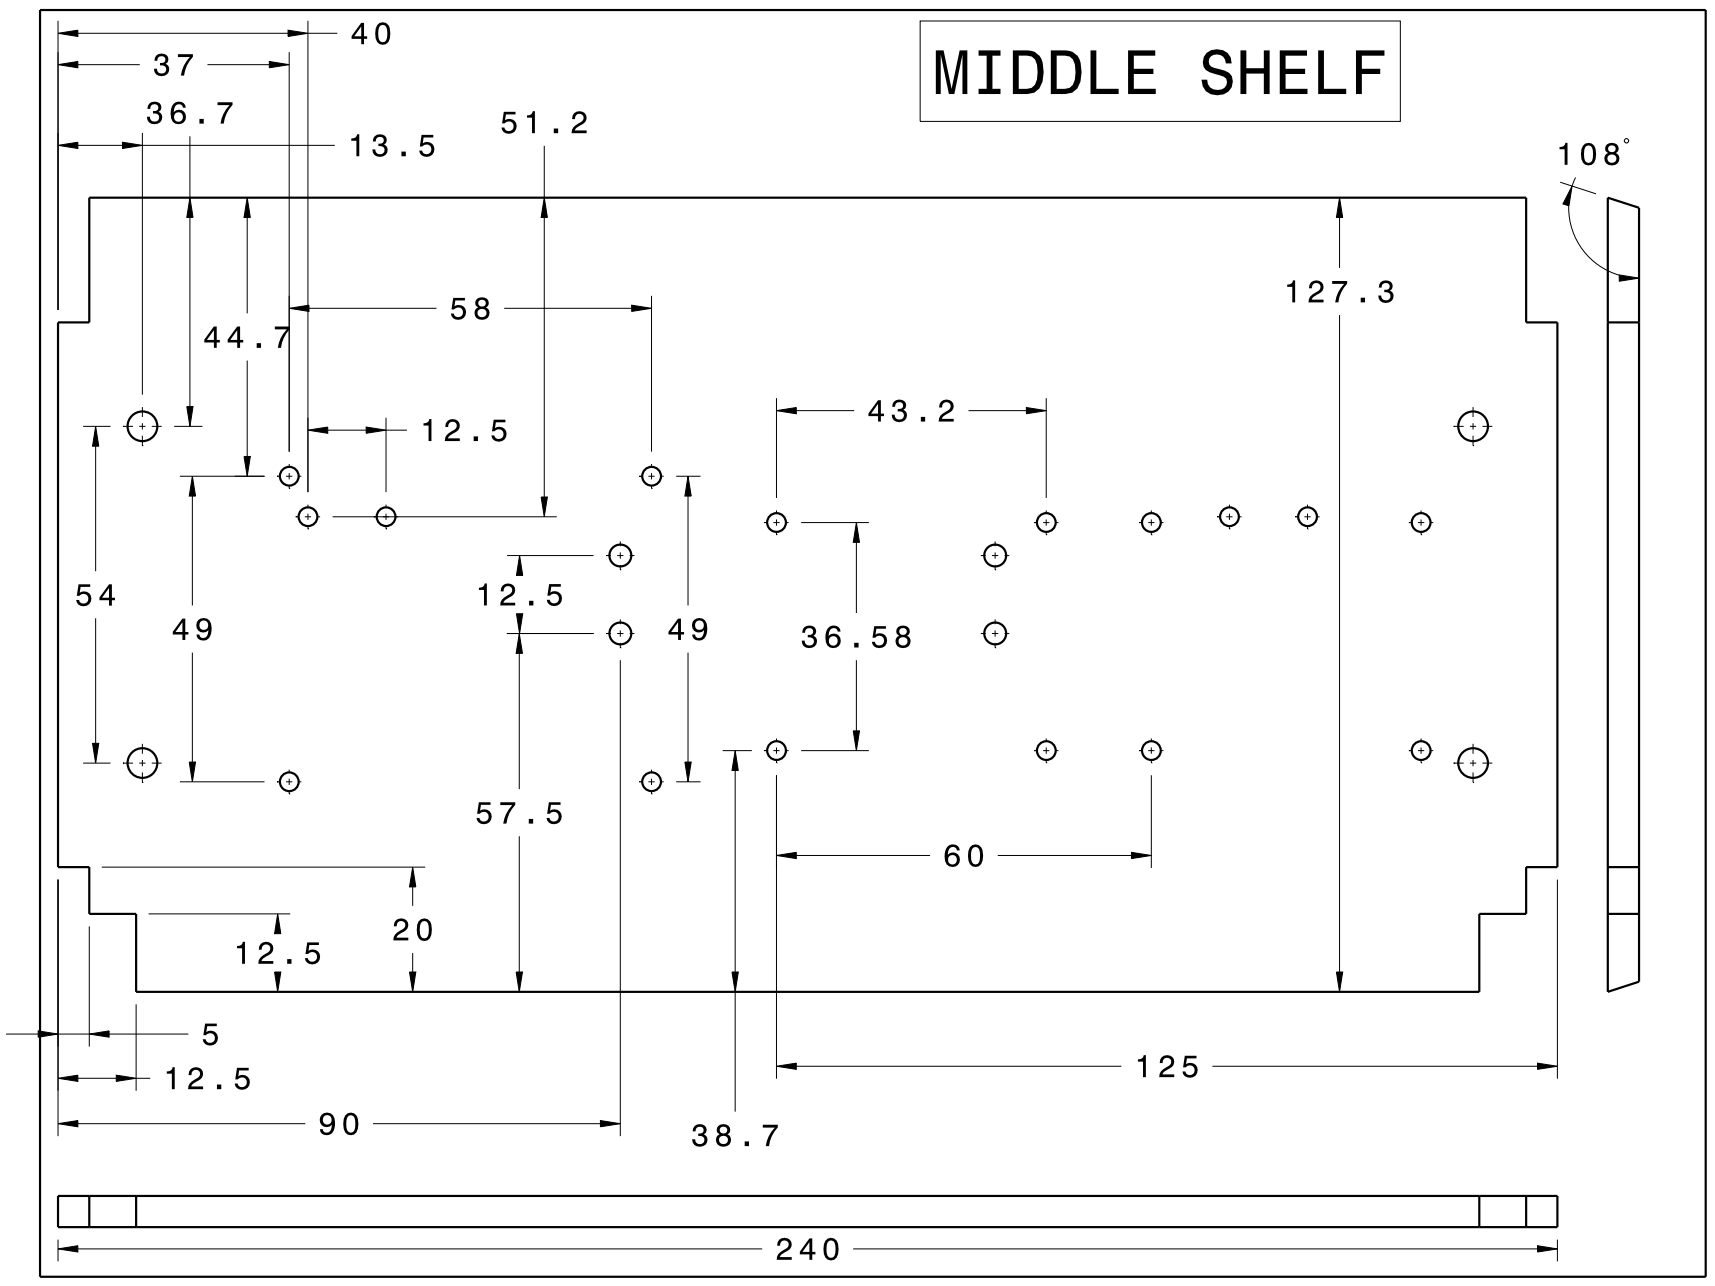
[picture p9: page 1]
