pjjefferies/Balance_Bot/drawings/Motor Mounting Bracket.pdf

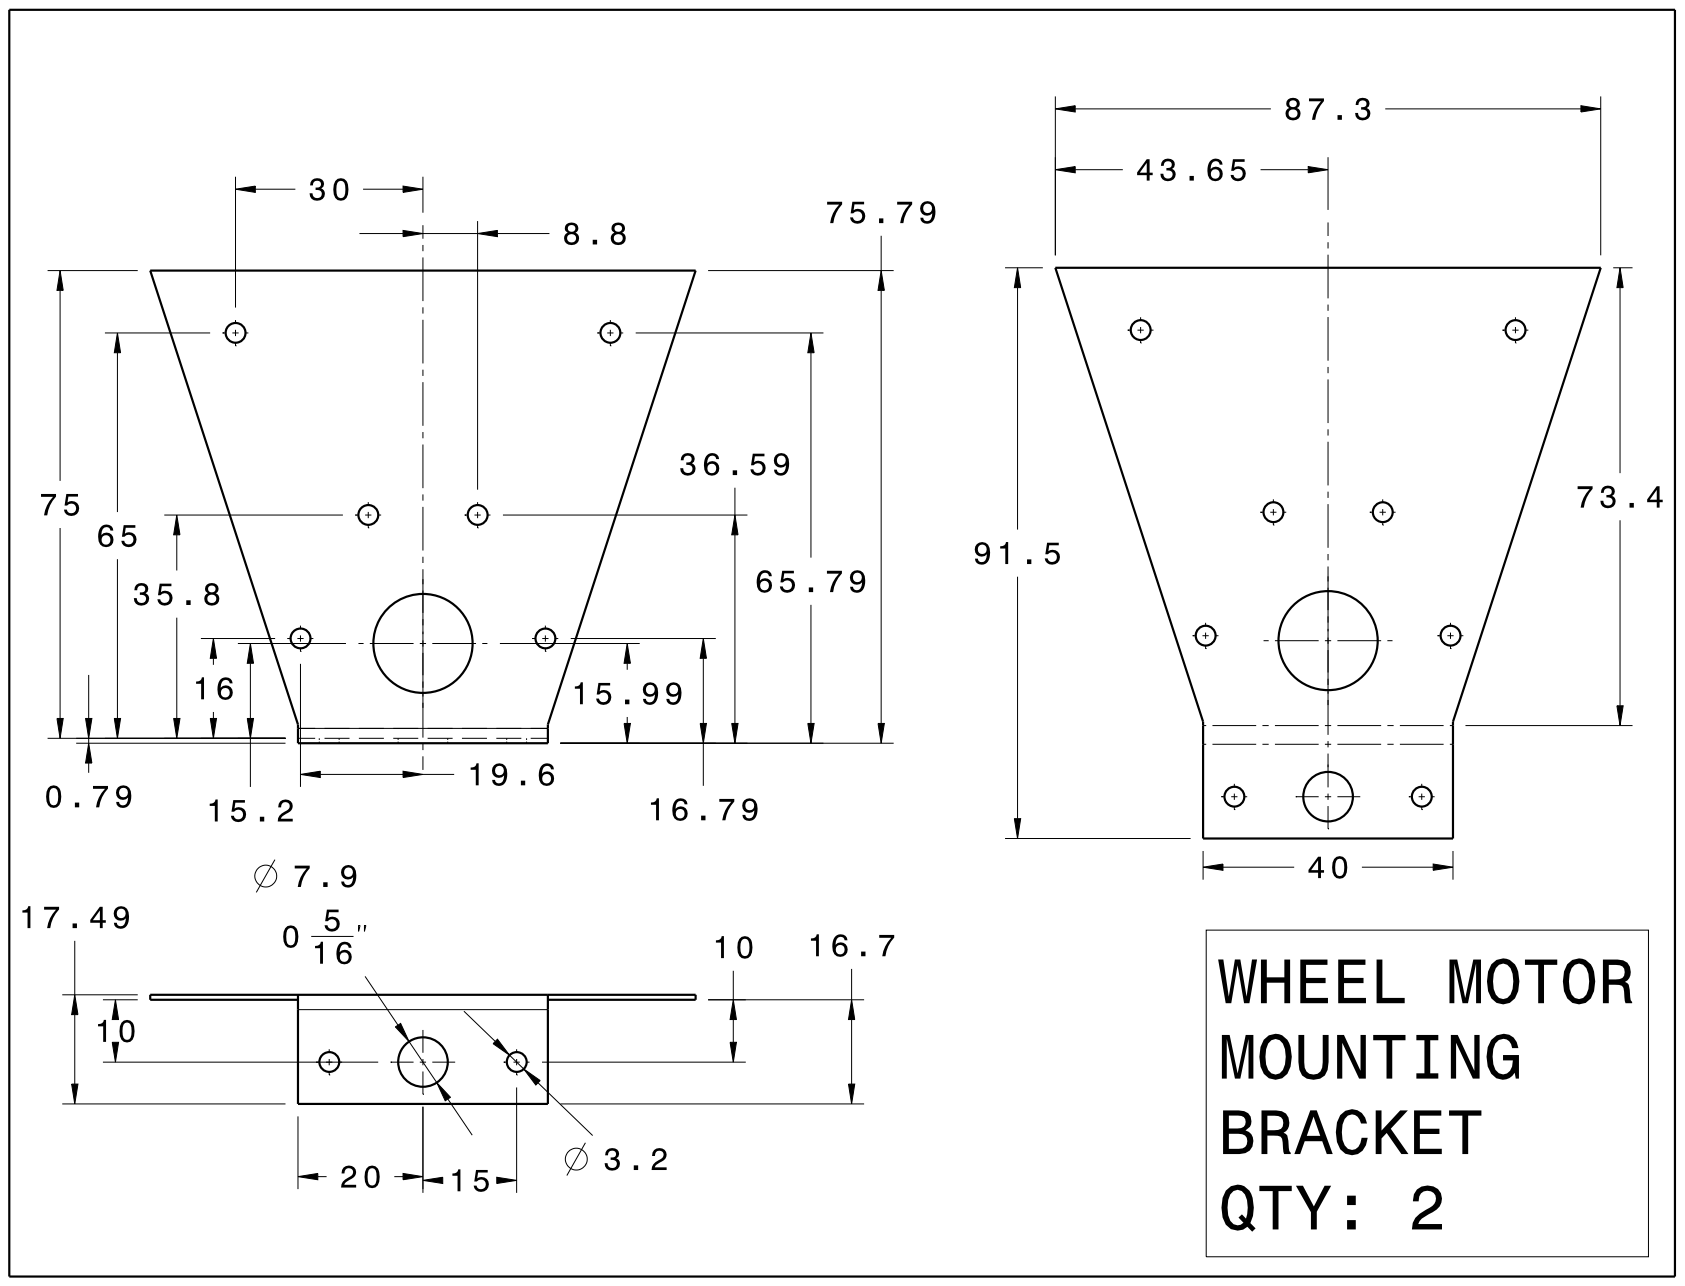
[picture p10: page 1]
