pjjefferies/Balance_Bot/drawings/Sensor Bracket.pdf

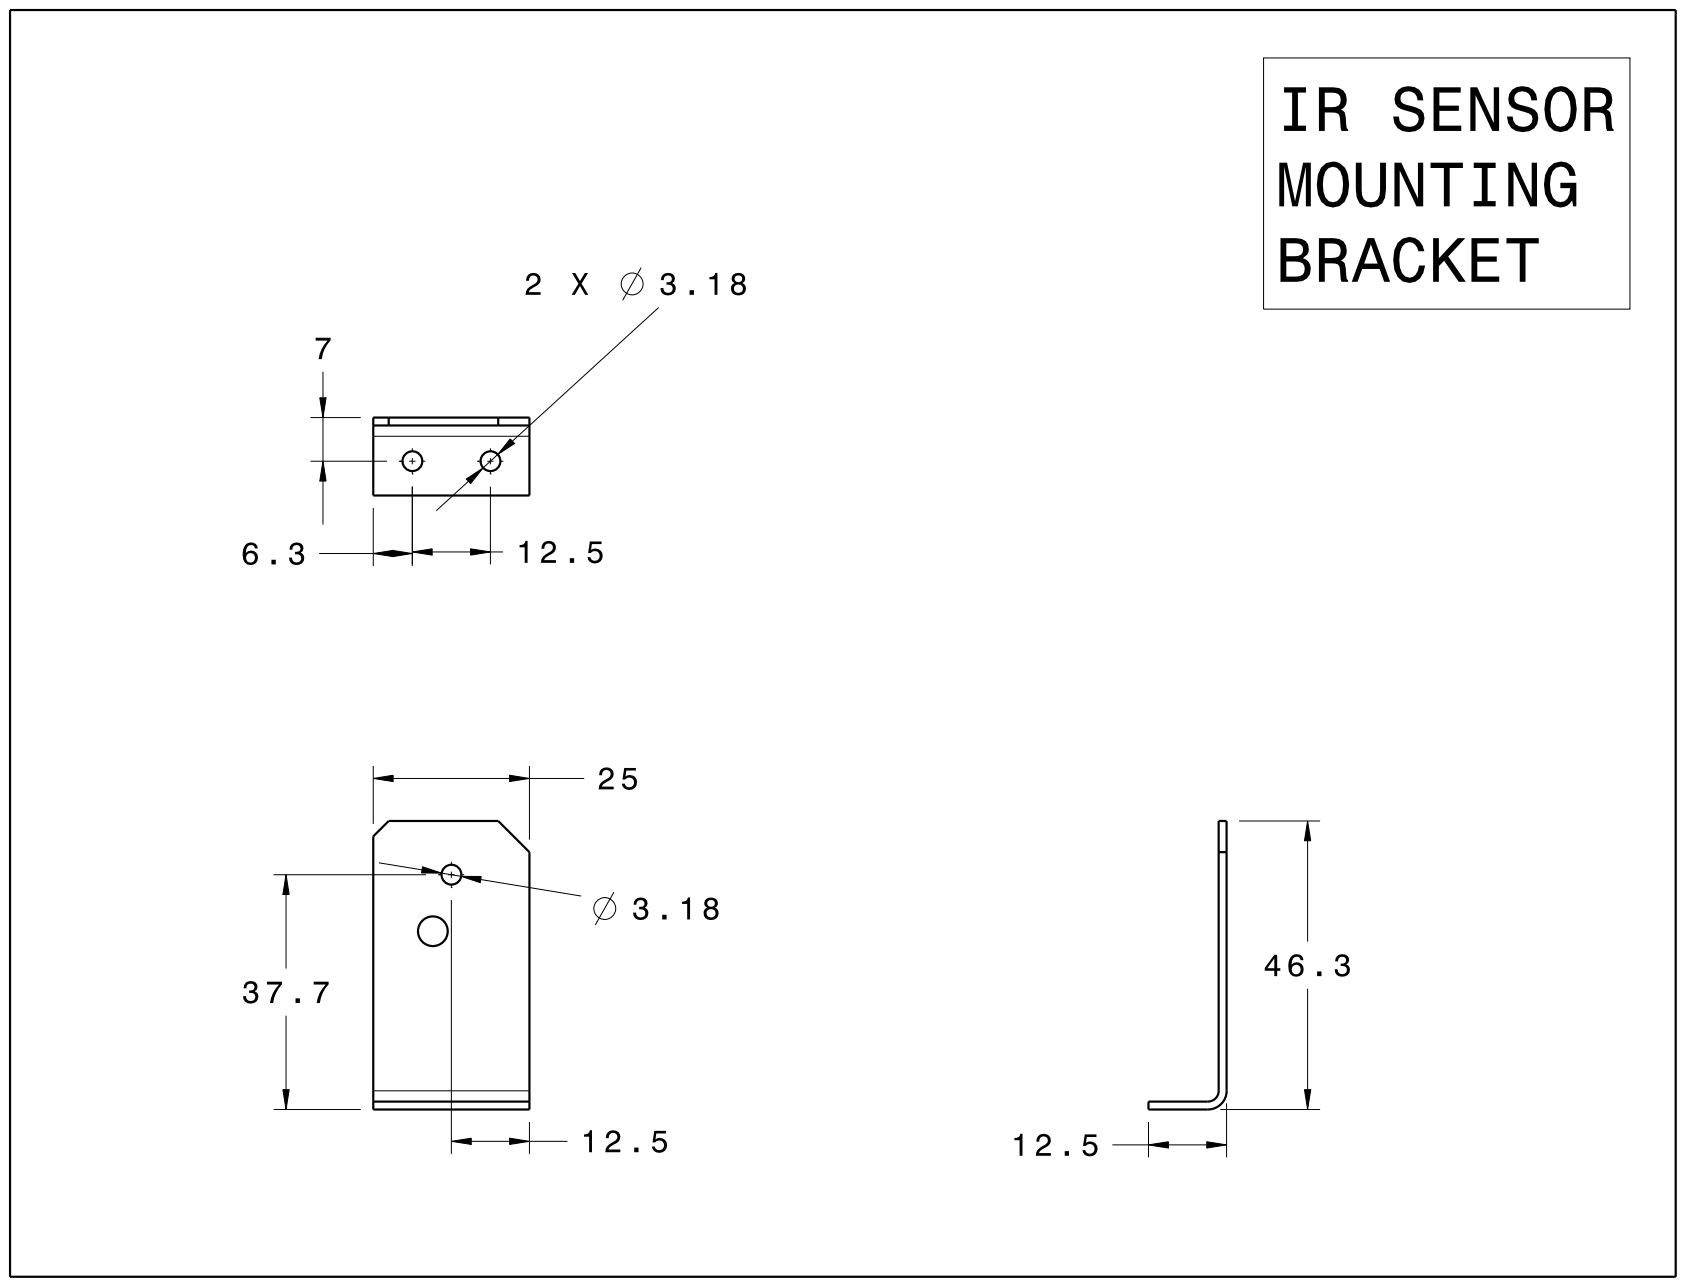
[picture p11: page 1]
