pjjefferies/Balance_Bot/drawings/Shelf Supports.pdf

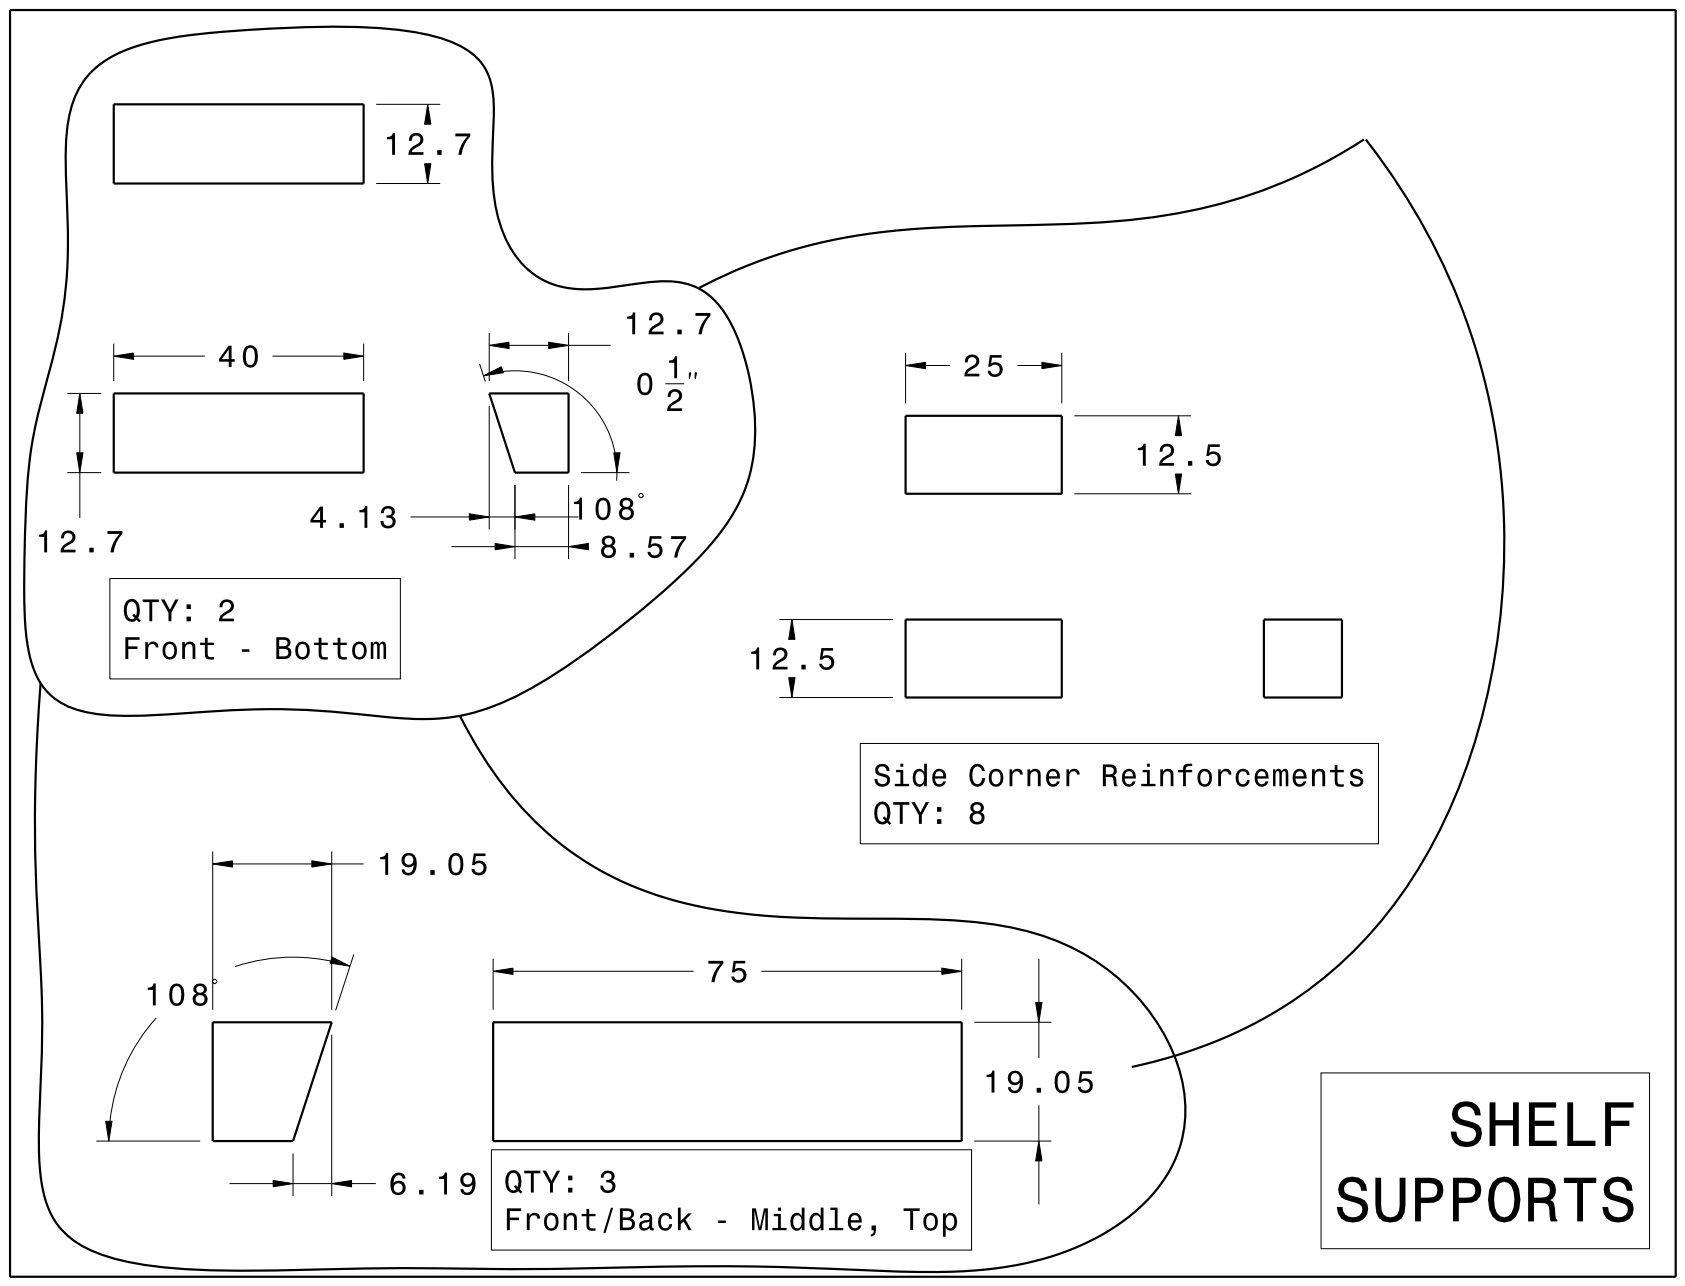
[picture p12: page 1]
