pjjefferies/Balance_Bot/drawings/Side Panel Asm.pdf

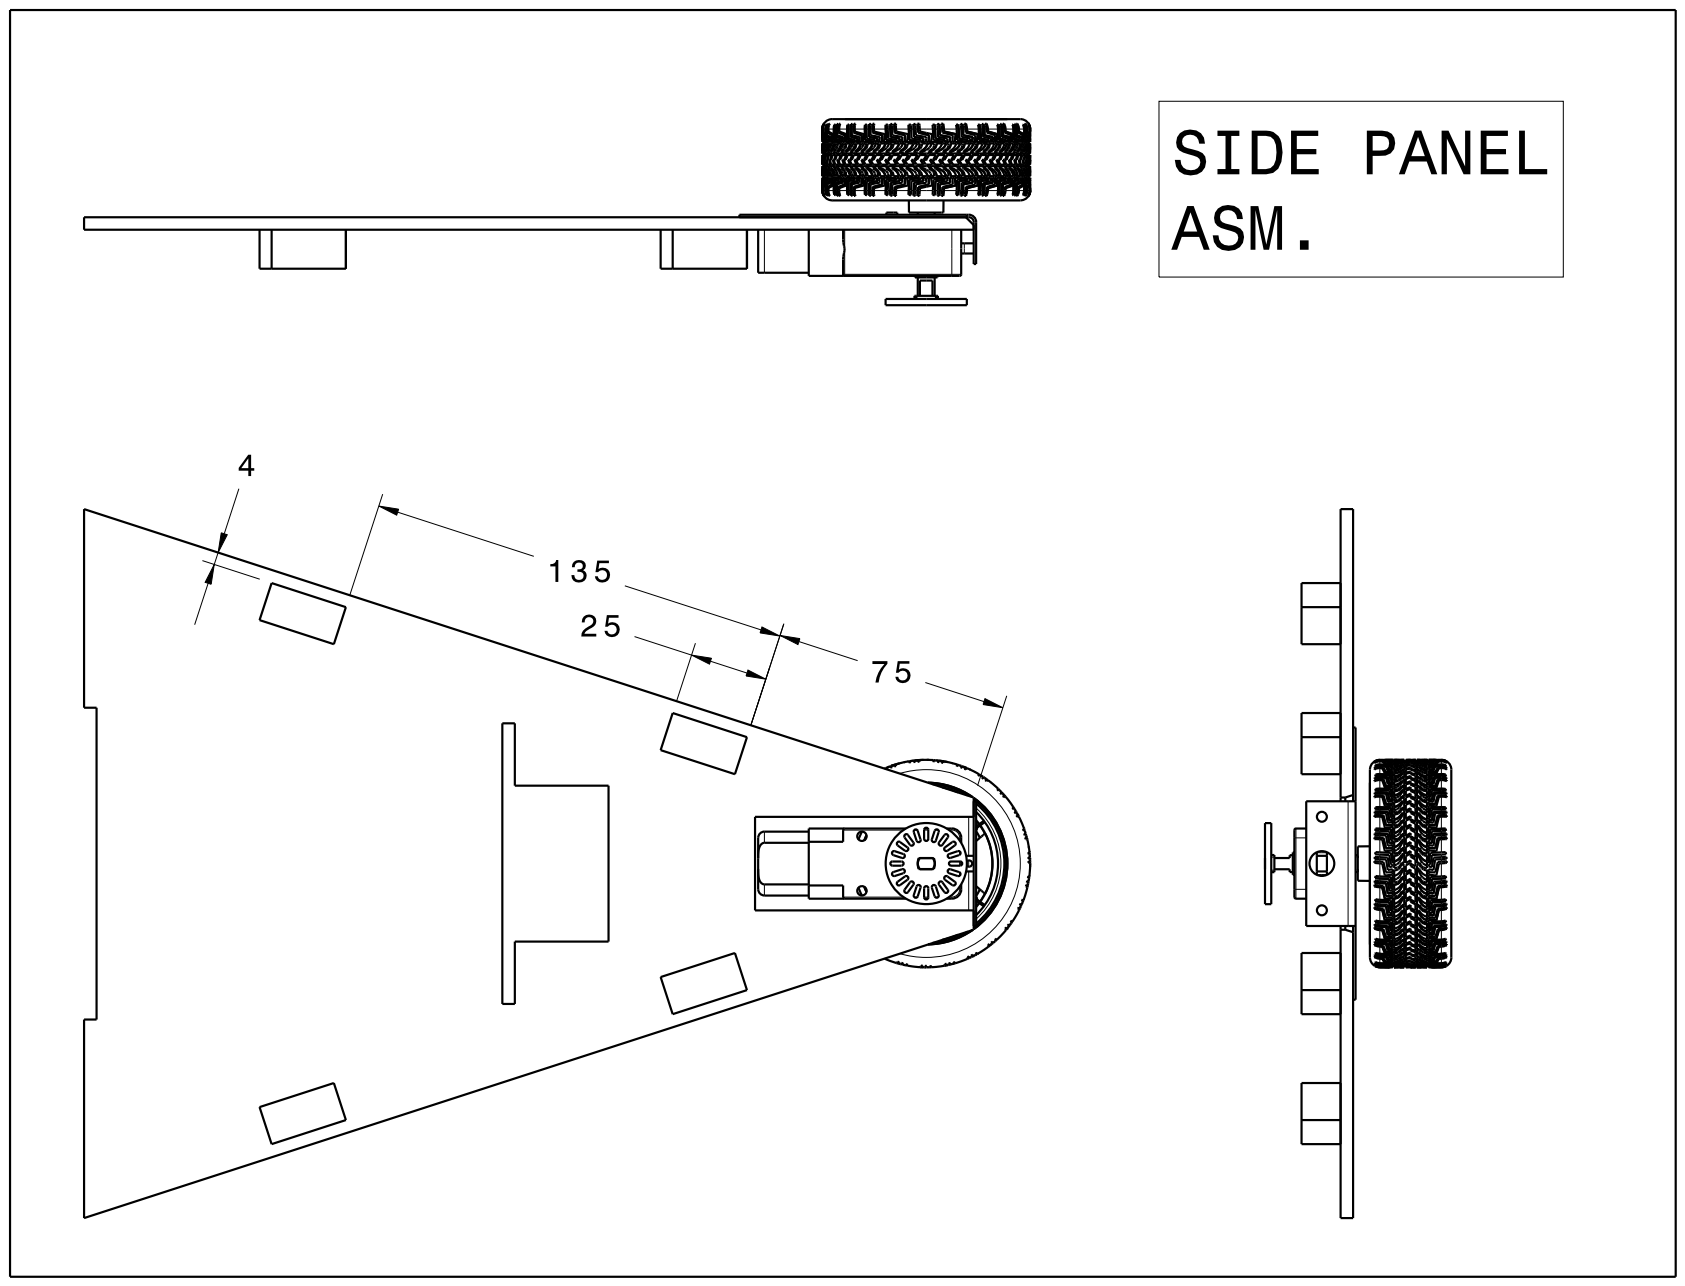
[picture p13: page 1]
