pjjefferies/Balance_Bot/drawings/Side Panel.pdf

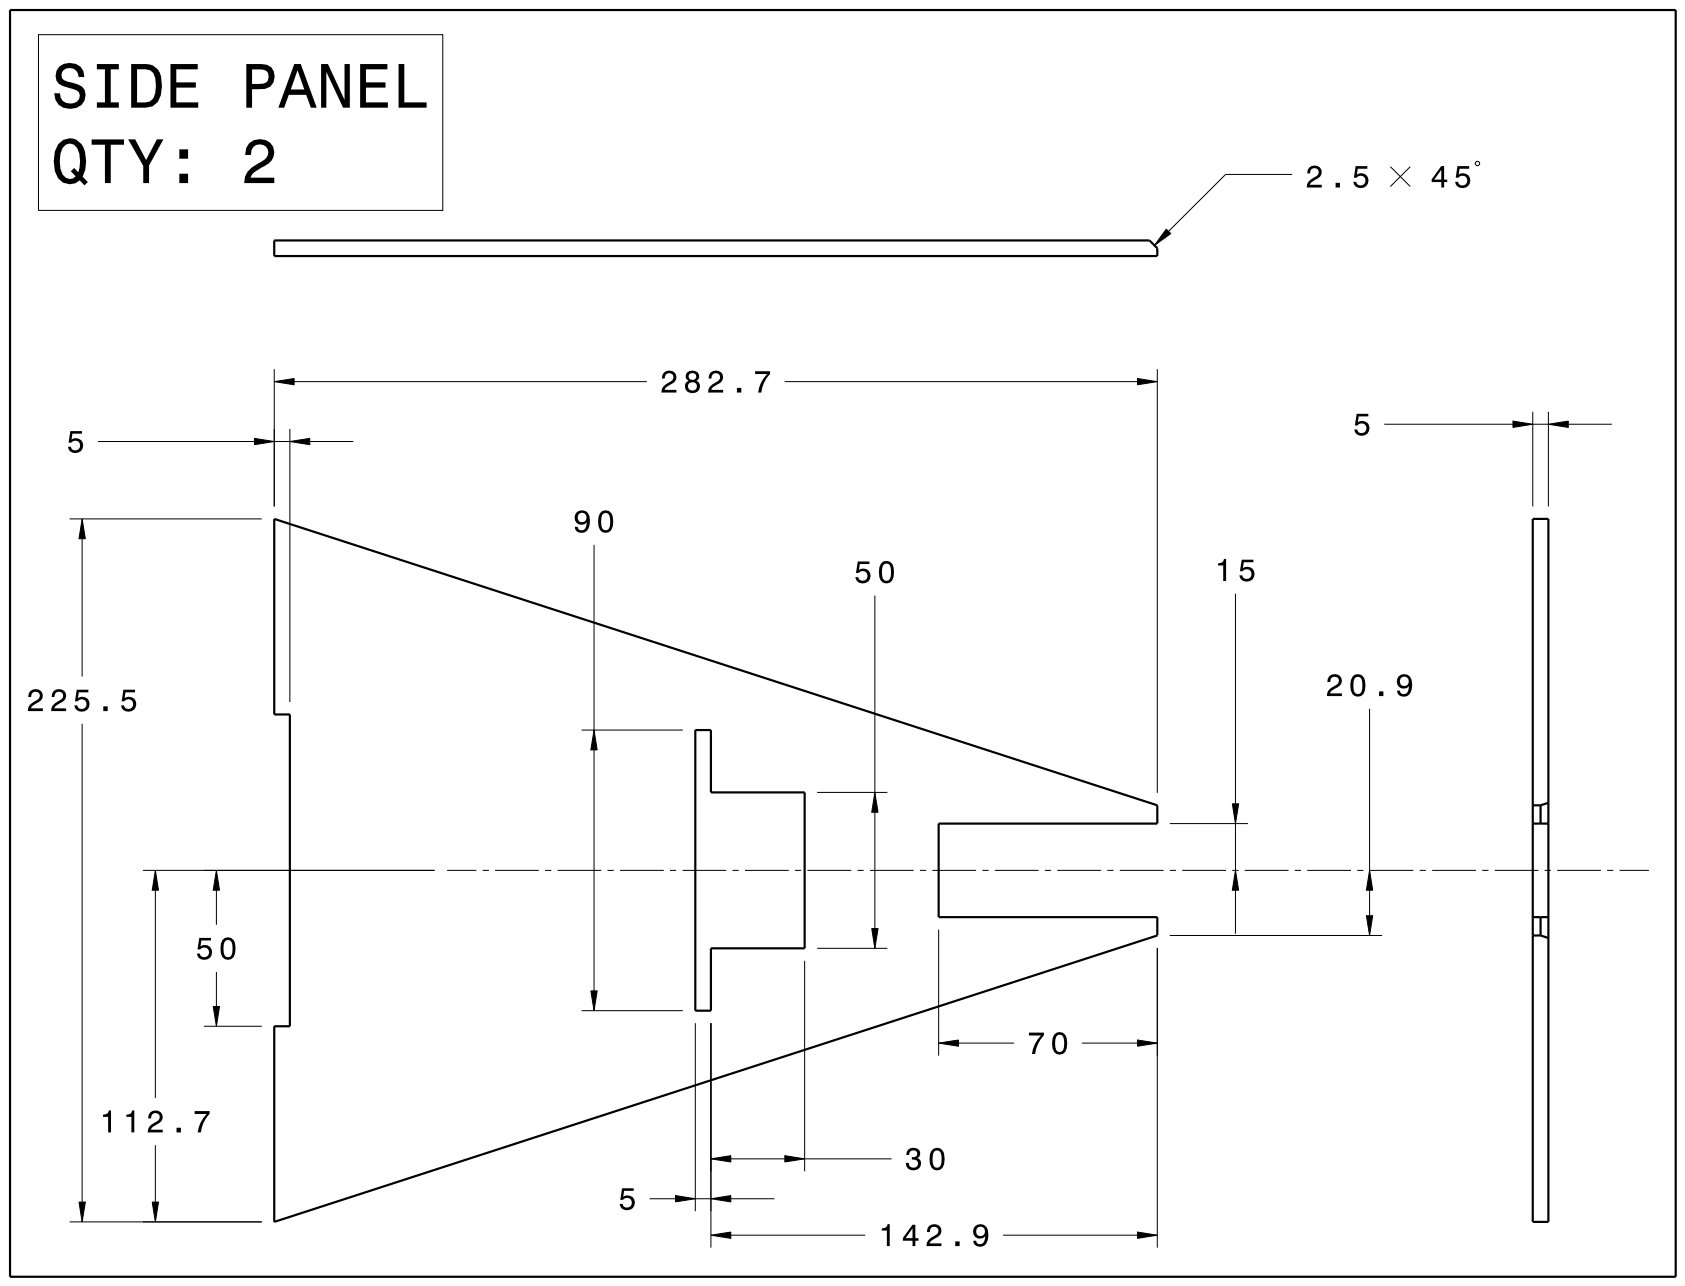
[picture p14: page 1]
