pjjefferies/Balance_Bot/drawings/Top Shelf Asm.pdf

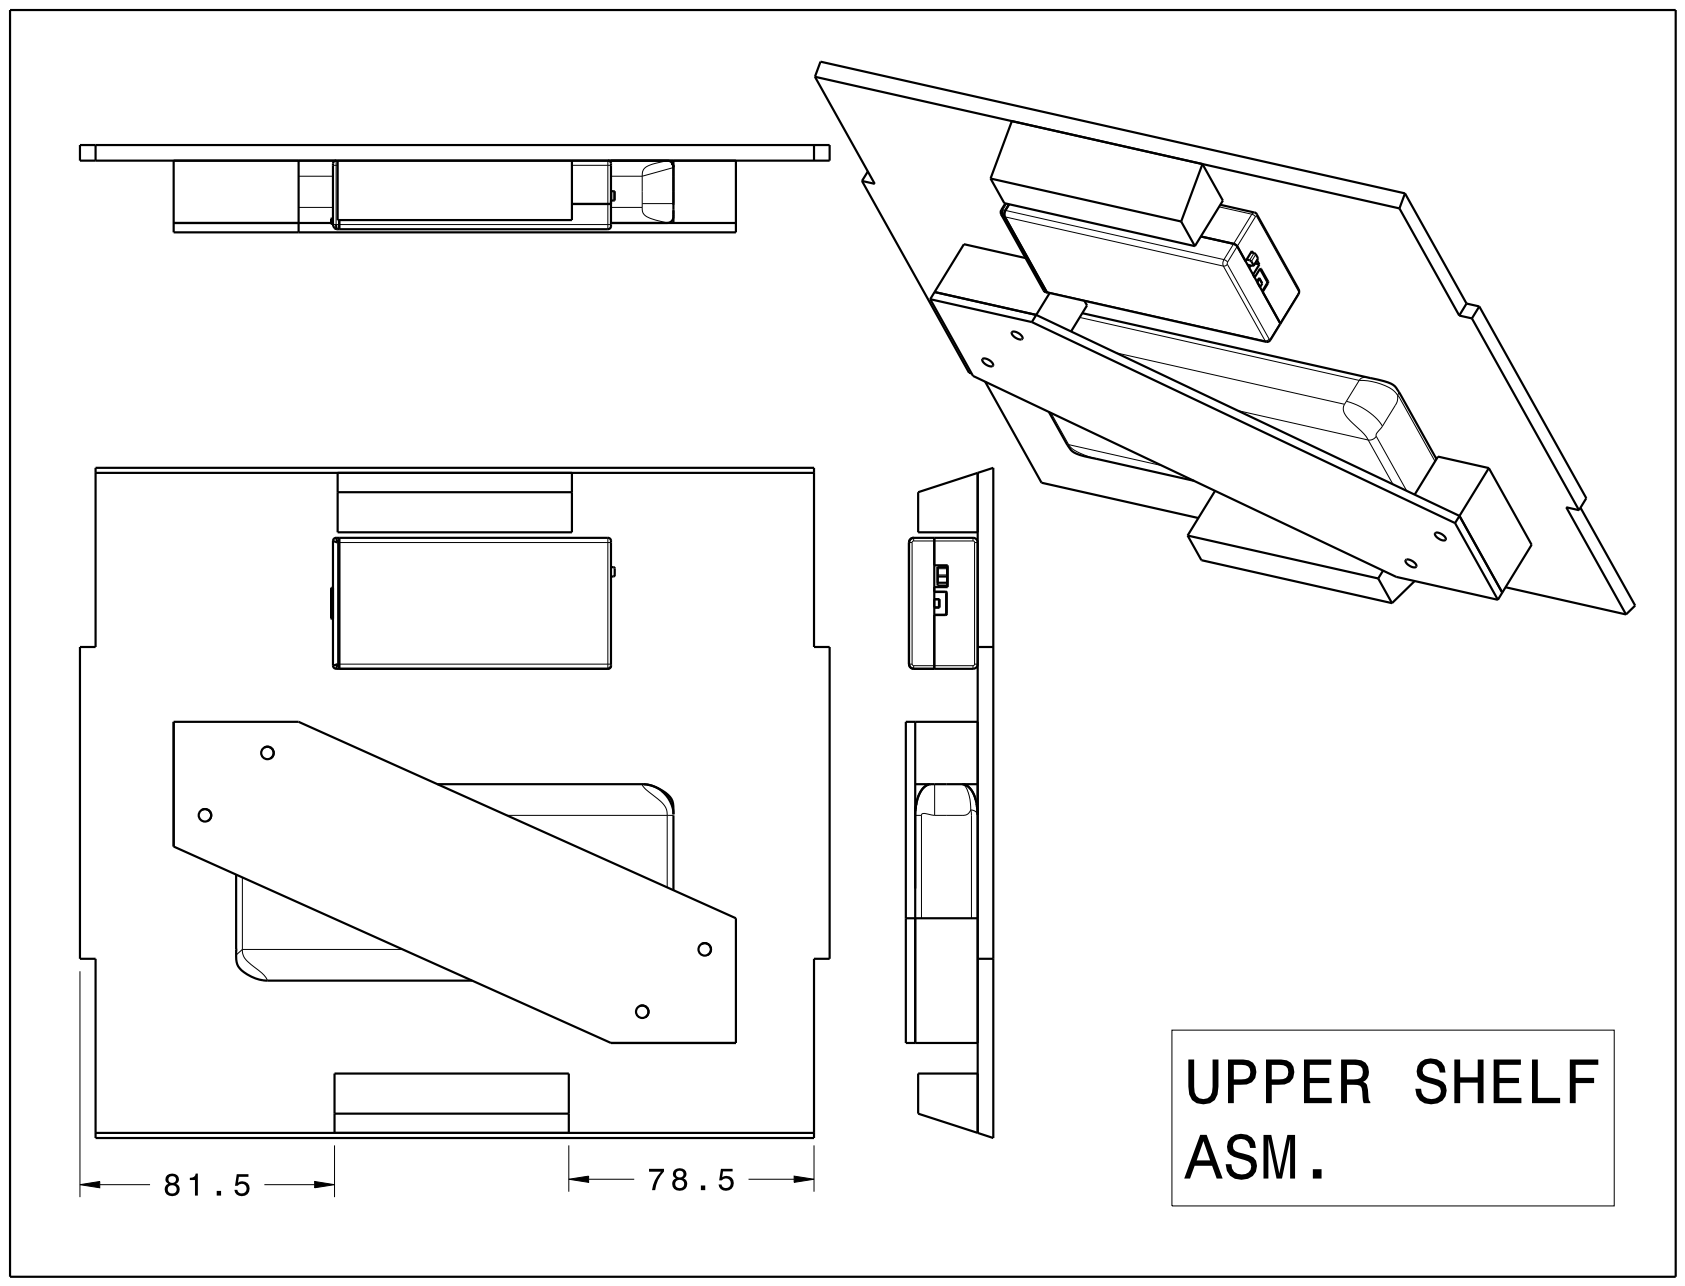
[picture p15: page 1]
