pjjefferies/Balance_Bot/drawings/Top Shelf.pdf

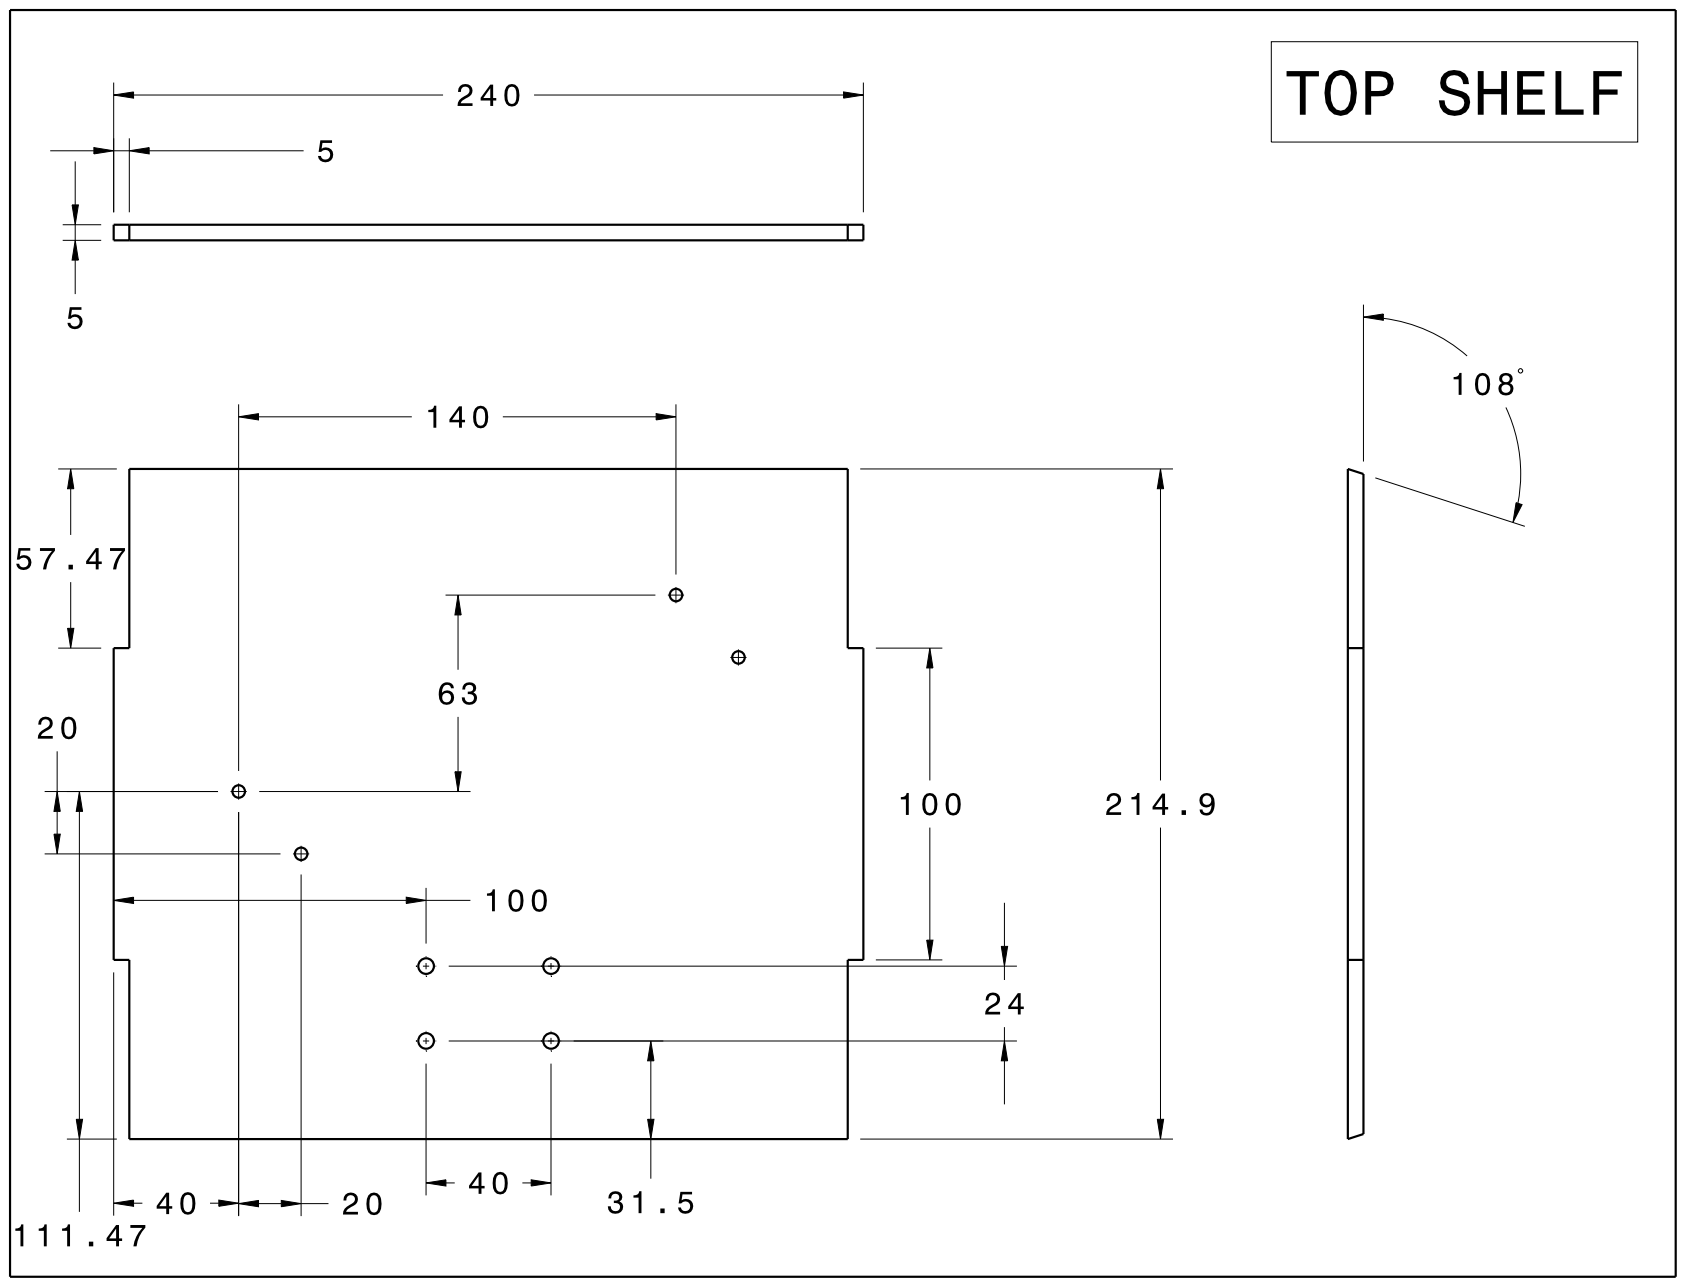
[picture p16: page 1]
