pjjefferies/Balance_Bot/drawings/Lower Shelf Brackets.pdf

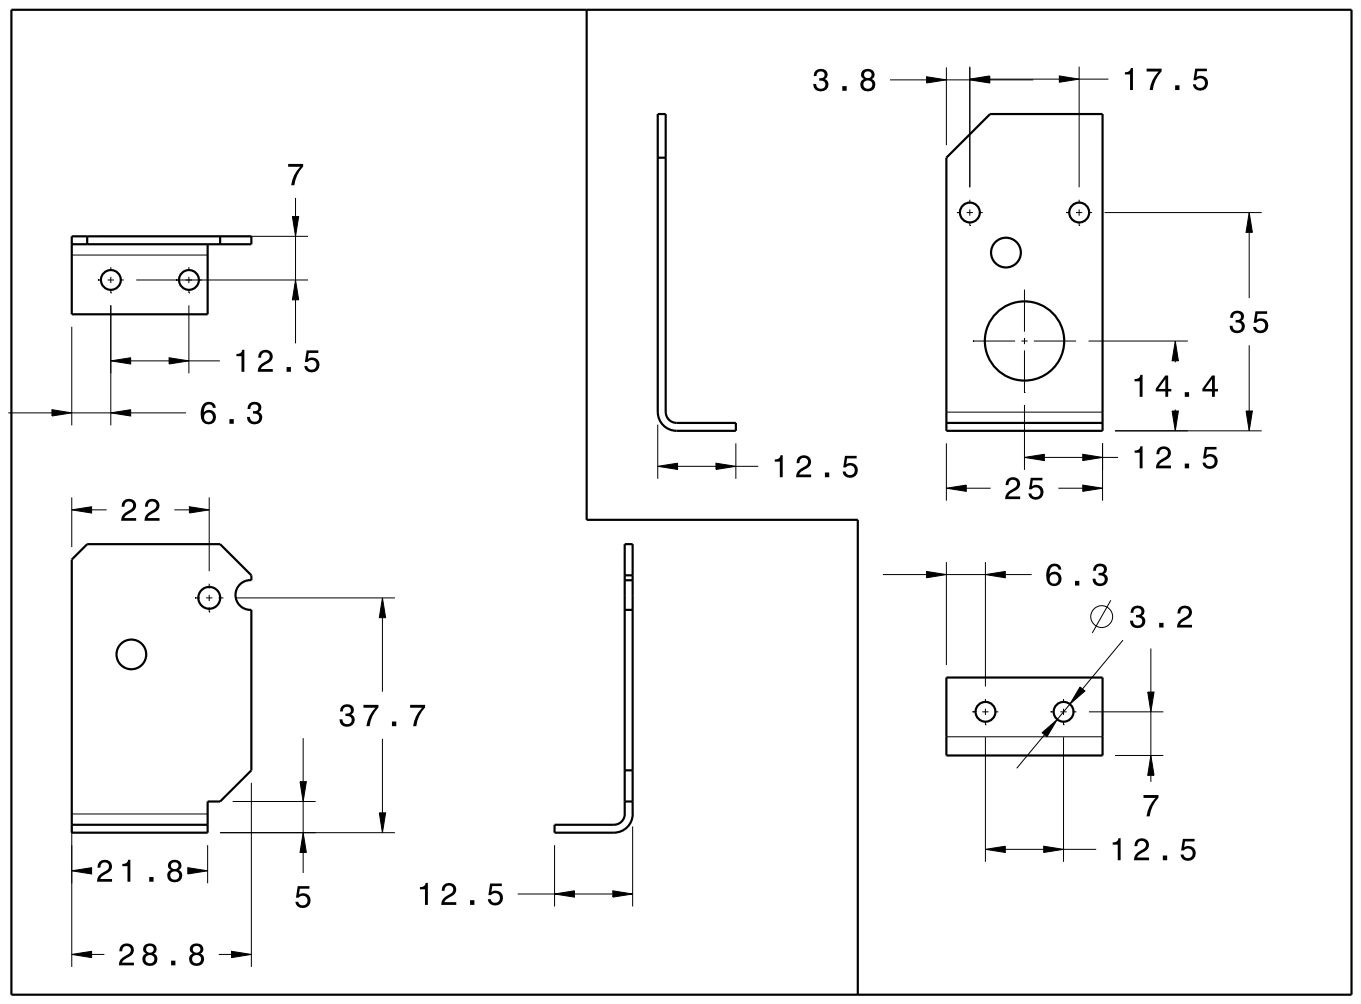
[picture p17: page 1]
