pjjefferies/Balance_Bot/src/motor/rpi_motor.py

from logging import Logger
from typing import Optional, Protocol

from gpiozero import Motor  # type: ignore


class MotorTemplate(Protocol):
    def __init__(
        self,
        forward: int | str,
        backward: int | str,
        enable: Optional[int | str],
        pwm: bool,
        pin_factory: Optional[None],
    ) -> None:
        ...

    def close(self):
        ...

    @property
    def value(self) -> float:
        ...

    @value.setter
    def value(self, value: float):
        ...


AVAIL_GPIO_PINS: list[int | str] = list(range(2, 28)) + [
    "GPIO" + str(a_no) for a_no in range(2, 28)
]


class RPI_Motor:
    """Object for indivisual Motor control - direction, speed"""

    def __init__(
        self,
        *,
        forward: int | str,
        backward: int | str,
        pwm: bool = True,
        logger: Logger,
    ):
        if forward not in AVAIL_GPIO_PINS or backward not in AVAIL_GPIO_PINS:
            raise ValueError(
                f"forward and rearward must be one of the following: {AVAIL_GPIO_PINS}"
            )
        self._motor: MotorTemplate = Motor(forward=forward, backward=backward, pwm=pwm)
        self._motor.value = 0
        self._forward_pin = forward
        self._backward_pin = backward
        self._logger = logger
        self._logger.info(
            msg=f"robot moved: RPI_Motor created with pins {forward} and {backward}"
        )

    @property
    def value(self) -> float:
        self._logger.info(
            f"robot moved: RPI_Motor, on Pins {self._forward_pin} and {self._backward_pin}, moving at velocity: {self._motor.value}"
        )
        return self._motor.value

    @value.setter
    def value(self, value: float) -> None:
        """
        Method to move motor
        velocity:  1 = Forward at full speed
        velocity:  0 = Stop
        velocity: -1 = Rearward at full speed
        """
        velocity = min(max(value, -1), 1)
        self._motor.value = velocity
        self._logger.info(
            f"robot moved: RPI_Motor, on Pins {self._forward_pin} and {self._backward_pin}, moving at velocity: {self._motor.value}"
        )

    def stop(self) -> None:
        self._motor.value = 0
        self._logger.info(
            f"robot moved: RPI_Motor, on Pins {self._forward_pin} and {self._backward_pin}, stopped"
        )

    def close(self):
        self._motor.close()
        self._logger.info(
            f"robot moved: RPI_Motor, on Pins {self._forward_pin} and {self._backward_pin}, destroyed"
        )
