pjjefferies/Balance_Bot/tests/test_robot_balance.py

#!/usr/bin/env python3

import time
from abc import abstractmethod
from typing import Callable, Optional, Protocol

import board  # type: ignore
import busio  # type: ignore
from box import Box

from src.config.config_main import load_config
from src.motor.motor_battery_relay import MotorBatteryRelay
from src.motor.rpi_motor import RPI_Motor
from src.robot_logging.logging_setup import bb_logger as logger
from src.sensor import bb_bno055_sensor as bno055


class MotorGeneral(Protocol):
    def __init__(
        self,
        forward: Optional[int] = None,
        backward: Optional[int] = None,
        enable: Optional[int] = None,
        pwm: bool = True,
        pin_factory: None = None,
    ):
        ...

    @property
    def value(self) -> float:
        ...

    @value.setter
    def value(self, value: float) -> None:
        ...


class BBAbsoluteSensorGeneral(Protocol):
    def __init__(self) -> None:
        ...

    @abstractmethod
    def calibrate_sensor(self) -> None:
        ...

    @abstractmethod
    def temperature(self, units: str) -> float:
        ...

    @property
    @abstractmethod
    def accel(self) -> dict[str, float]:
        ...

    @property
    @abstractmethod
    def magnetic_bb(self) -> dict[str, float]:
        ...

    @property
    @abstractmethod
    def gyro_bb(self) -> dict[str, float]:
        ...

    @property
    @abstractmethod
    def euler_angles(self) -> dict[str, float]:
        ...

    @property
    @abstractmethod
    def gravity_dir(self) -> dict[str, float]:
        ...

    @property
    @abstractmethod
    def gravity_mag(self) -> float:
        ...


TIME_MS: Callable[[], int] = lambda: int(time.time() * 1000)
TIME_S: Callable[[], int] = lambda: int(time.time())


def test_robot_balance() -> None:
    """Basic Robot Balance Test"""
    cfg: Box = load_config()

    # set-up Wheel Motor Power Relay
    motor_power_relay = MotorBatteryRelay(gpio_pin_no=cfg.wheel.power, logger=logger)

    # Set-up Wheel Motor Control Pins
    motor_wheel_left: RPI_Motor = RPI_Motor(
        forward=cfg.wheel.left.motor.fwd,
        backward=cfg.wheel.left.motor.rwd,
        pwm=True,
        logger=logger,
    )
    motor_wheel_right: RPI_Motor = RPI_Motor(
        forward=cfg.wheel.right.motor.fwd,
        backward=cfg.wheel.right.motor.rwd,
        pwm=True,
        logger=logger,
    )

    # Initialize i2C Connection to sensor
    # TODO: need check/try?
    i2c = busio.I2C(scl=board.SCL, sda=board.SDA, frequency=1_000)  # type:ignore
    sensor: bno055.BB_BNO055Sensor_I2C = bno055.BB_BNO055Sensor_I2C(
        i2c=i2c, logger=logger
    )

    # Read Sensor Mode to verify connected
    sensor.mode

    # Read saved sensor calibration values
    sensor_calibration_data = sensor.read_calibration_data_from_file()
    sensor.write_calibration_data_to_sensor(
        sensor_calibration_data=sensor_calibration_data
    )

    # Start Balance Loop
    logger.info(msg="about to start Balance Loop")

    motor_power_relay.on()
    logger.info(msg="Main loop started")
    # Get Initial Values for PID Filter Initialization
    temp_euler: Box = Box(sensor.euler_angles)
    # roll_last: float = temp_euler["x"]
    pitch_last: float = temp_euler.y
    # yaw_last: float = temp_euler["z"]

    # Set initial instructions to stand still
    pitch_setpoint_angle: float = 0
    ## yaw_setpoint_angle: float = 0
    # previous_fore_aft_motor_input: float = 0

    # Set initial integral sum for PID control to zero
    integral_term: float = 0
    derivative_term: float
    proportional_term: float
    lasttime_control: int = TIME_MS()
    lasttime_params_updated: int = TIME_S()
    # roll: float
    pitch: float
    # yaw: float
    fore_aft_error: float
    motor_output: float
    motor_left_output: float
    motor_right_output: float
    temp_temp_euler: Box
    good_euler_angles: int = 0
    bad_euler_angles: int = 0
    while True:
        try:
            if (TIME_MS() - lasttime_control) >= cfg.duration.control_update:
                # exec every CONTROL_UPDATE_INTERVAL msec.
                lasttime_control = TIME_S()
                temp_temp_euler = temp_euler
                try:
                    temp_euler = sensor.euler_angles
                    good_euler_angles += 1
                except OSError:
                    temp_euler = temp_temp_euler
                    bad_euler_angles += 1
                # roll = temp_euler["x"]
                pitch = temp_euler.y
                # yaw = temp_euler["z"]
                fore_aft_error = pitch - pitch_setpoint_angle
                if integral_term == 0 or fore_aft_error / integral_term > 1:
                    integral_term = cfg.pid_param.k_integral * fore_aft_error
                elif fore_aft_error / integral_term < 1:
                    integral_term = cfg.pid_param.k_integral * fore_aft_error
                else:
                    integral_term = 0
                # self._integral_term = max(self._integral_term, bbc.MOTOR_MIN)
                # self._integral_term = min(self._integral_term, bbc.MOTOR_MAX)
                derivative_term = cfg.pid_param.k_derivative * (pitch - pitch_last)
                proportional_term = cfg.pid_param.k_proportional * fore_aft_error
                motor_output = proportional_term + integral_term + derivative_term

                motor_left_output = motor_output
                # print(
                #     f"trb:175:motor_left_output: {motor_left_output}, cfg.wheel.left.motor.min_value: {cfg.wheel.left.motor.min_value}"
                # )
                motor_left_output = max(
                    motor_left_output, cfg.wheel.left.motor.min_value
                )
                motor_left_output = min(
                    motor_left_output, cfg.wheel.left.motor.max_value
                )
                motor_right_output = motor_output
                motor_right_output = max(
                    motor_right_output, cfg.wheel.right.motor.min_value
                )
                motor_right_output = min(
                    motor_right_output, cfg.wheel.right.motor.max_value
                )

                motor_wheel_left.value = motor_left_output
                motor_wheel_right.value = motor_right_output

                # roll_last, pitch_last, yaw_last = (roll, pitch, yaw)
                pitch_last = pitch
                logger.info(msg="Main loop ended")
            if (TIME_S() - lasttime_params_updated) >= cfg.duration.params_update:
                # exec every PARAMS_UPDATE_INTERVAL msec.
                lasttime_params_updated = TIME_S()
                logger.info(msg="Updating parameters")
                cfg = load_config()
                logger.info(
                    msg=f"9DOF sensor: Good Eulers: {good_euler_angles:8d}, Bad Eulers: {bad_euler_angles:8d}"
                )
        except KeyboardInterrupt:
            print("Falling and stopping at your request.")
            break

    motor_wheel_left.value = 0
    motor_wheel_right.value = 0
    motor_wheel_left.close()
    motor_wheel_right.close()
    motor_power_relay.off()
    motor_power_relay.close()


if __name__ == "__main__":
    test_robot_balance()
