pjjefferies/Balance_Bot/(commit log)

2020-09-09 Updating README.md to test update/commit from Raspberry Pi
2020-09-12 Initial Raspbery Pi Motor Control Test - Not tested yet
2020-09-14 Add mistakenly removed from repository files from Raspberry Pi folder
    [Motor_Control_Test.py, bluedot_test.py, bluezero_central_role_test.py, microbit_manual.py, read_remote_bt.py]
2020-10-10 Add kinematic calculations and cone proportion excel files
    [Balance Bot Lifting Calculations.xlsx, Cone Proportions Calculations.xlsx]
2020-10-10 Add BN055 Sensor Manual
2020-10-10 Add initial python program frameworks
2020-10-11 Added start-up file for testing motors
2020-11-27 Update analysis files
    [BOM, Balance Bot 001.xlsx, Balance Bot Lifting Calculations.xlsx, Cone Proportions Calculations.xlsx]
2020-11-27 rpi_motor Updated to use gpiozero instead of RPi.GPIO. Class changed to RPI_Motor to avoid conflict. Added to archive as unused.
    [rpi_motor.py]
2020-11-27 Encoder Sensor Module and RotationEncoder Object Created
2020-11-27 simple_robot created for bluedot steering of two wheeled robot
2020-11-27 Math import commented-out from balance_bot as currently unused
2020-11-27 simple_robot updated to use balance_bot_config for set-up and import encoder sensor but not use yet
2020-12-10 Restructure Folders. Move CAD to private repository.
    [BOM, Balance Bot 001.xlsx, Balance Bot Electrical Connection.xlsx, Balance Bot Electrical Diagram.kicad_pcb, Balance Bot Electrical Diagram.sch, Balance Bot Lifting Calculations.xlsx, Cone Proportions Calculations.xlsx]
2020-12-20 Drawings Updated to Add Wiring Holes in Middle Shelf and clarify shelf supports
2020-12-20 Add Pin definition for Sensor in config file
2020-12-20 Add testing/demo for encoder_sensor module / object
2020-12-21 In encoder_sensor.py, change print statements to logging
2020-12-21 Update sensor_test.py to get all sensor info, just need to save it now
2020-12-24 Updated sensor test to check/wait for calibration
2020-12-24 Update sensor_test.py to save sensor readings in pandas dataframe and save as JSON
2020-12-24 encoder_sensor_with_motor_test.py created and started
2020-12-25 Changed average duration to be public object attribute instead of method parameter so @property can be used
    Removed lines 67-84 are left-over from encoder_sensor.py copy
2021-01-25 Wiring Table Updated to be list instead of 2D Matrix with color codes
    [Balance Bot Electrical Connection.xlsx]
2021-02-06 Created py_motor_test_auto.py to test motors on bot only. Updated simple_robot.py to not use sensor yet and print bluedot input Changed bluedot_direction_control.py wrapper to output y (speed), x (tu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
2021-02-06 Update Balance Bot Electrical Connection.xlsx
    [Balance Bot Electrical Connection.xlsx]
2021-02-15 Many debugs of sensor_test.py - working ok so far
2021-02-18 Adding log file for excel analysis - 10 s of Euler Angles and Magnetrometer readings as fast as possible
    [sensor_history-2021-02-18_052117.csv]
2021-02-19 sensor_test.py updated to align axes for accel, gyro and euler angles
2021-02-24 Update Project Structure based on recommendations from https://medium.com/bcggamma/data-science-python-best-practices-fdb16fdedf82
    Added package structure, configuration management, logging
    [Balance Bot Electrical Connection.xlsx, sensor_history-2021-02-18_052117.csv]
2021-02-25 Restructure still in process...
    [bno055_calibration_data.yml]
2022-10-23 Minor update to get Pi and Computer synced
    [Balance Bot Electrical Connection.xlsx]
2022-11-12 Generic encoder sensor object created
2022-11-12 Digital Encoder Sensor renamed and updated to use general sensor super
2022-11-12 Encoder Sensor Simulator Class created
2022-11-12 Sensor tests moved to tests\function folder
2022-11-12 Motor simulator created
2022-11-12 bno055 sensor updated to use protocol and inheritance
2022-11-12 No updates
    [Balance Bot Electrical Connection.xlsx]
2022-11-13 Encoder Sensor Files Type Hint Updates
2022-11-13 bno055 calibration config file renamed
    [bno055_calibration_config.yml, bno055_calibration_data.yml]
2022-11-13 9DOG Sensor Config File Location changed
2022-11-13 9DOF sensor config load removed. Type hints added
2022-11-16 Change config location for encoder to motor calibration for simulator
2022-11-27 Distance (traveled) property added to encoder_sensor_general class
2022-11-27 Robot encoder sensor event handler event type corrected
    [encoder_sensor_general.py]
2022-11-28 Arm Motors turned off in balance_bot
2022-11-28 In balance_bot, EventHandlerTemplate added for reference in Sensor template
2022-11-28 Encoder and Template in balance_bot updated from "Rotation"
2022-11-28 In balance_bot, timer name shortcut names updated to TIME_S, TIME_MS
    [balance_bot.py]
2022-12-05 Change to make Python 3.7.3 compatible due to package availability on Raspberry Pi
2022-12-06 Undo Change to make Python 3.7.3 compatible due to package availability on Raspberry Pi
2022-12-06 Revert "Undo Change to make Python 3.7.3 compatible due to package availability on Raspberry Pi"
    This reverts commit 39d4dc2131a9dc80b3063869dcfbb5906314ce24.
    [balance_bot.py, bb_9dof_sensor_simulator.py, bb_bno055_sensor.py, bluedot_direction_control.py, config.py, encoder_sensor_digital.py, encoder_sensor_general.py, encoder_simulator.py]
2022-12-11 Back to Python <V.10 - Can't Get V.11 working with dbus, etc. on Raspberry Pi
2022-12-17 Relay added to control Motor Controller Supply Power with Raspberry Pi
2022-12-20 Updated Electrical spreadsheet to show Motor battery relay
    [Balance Bot Electrical Connection.xlsx]
2022-12-22 Sensor history file moved to logs folder
    [sensor_history-2021-02-18_052117.csv]
2022-12-22 Motor and Encoder File renamed and recreated not based on simple_robot
2022-12-22 Added comment filter to test_motor_encoder module
2022-12-22 Created progtest_left50-10s_right50-10s.csv to test motors and encoders
    [progtest_left50-10s_right50-10s.csv]
2022-12-23 Corrected encoder distance to use _current_history_len instead of _history_lines_to_use
    [encoder_sensor_general.py]
2022-12-24 various corrections to test_motor_encoder
    [test_motor_encoder.py]
2022-12-24 test_motor_encoder logic corrected to include all tests, not just last one
    [test_motor_encoder.py]
2022-12-24 Added close to motor and Encoder to release GPIO Pins
2022-12-24 Added close to motor power relay to release gpio pin
2022-12-24 Added __init__.py and renamed program_flow.txt from 'program flow.txt'
2022-12-24 Debug print lines added robot_listener.py
2022-12-24 Mostly updates to get event handlers working
    [progtest_left50-10s_right50-10s.csv]
2022-12-24 Added event notifications to encoder_sensor_digital
2022-12-24 rpi_motor re-implemented as rpiozero Motor wrapper for event notification, speed range limiting, et. al.
2022-12-24 Clean-up of rpi_motor and sensor files
2022-12-24 Replace many prints with event posts in test_motor_encoder.py
    [test_motor_encoder.py]
2022-12-25 Created motor, encoder test program to calibrate encoders
    [progtest_leftright-100-+100x10s.csv]
2023-01-03 Add logs to repository
    [progtest_left50-2x20s_right50-2x20s.csv]
2023-01-03 Added post position_history when closing sensor to csv file
2023-01-03 Encoder Sensor logging history fixed. Set of sample logs
    [encoder_sensor_digital.py, robot_listener.py]
2023-01-03 Sensor sample logs added
    [2023-01-02_23_45_12_position_history.csv, 2023-01-02_23_45_34_position_history.csv, 2023-01-02_23_45_56_position_history.csv, 2023-01-02_23_46_18_position_history.csv]
2023-01-10 Digital Encoder Sensor change to trigger every slot instead of every slot and post.
2023-01-10 Add 4 log files with full-slot move detection test
    [2023-01-09_23_47_31_position_history.csv, 2023-01-09_23_47_53_position_history.csv, 2023-01-09_23_48_15_position_history.csv, 2023-01-09_23_48_37_position_history.csv]
2023-01-10 Change digital encoder sensor to detect slot and posts again
2023-02-11 Correct EventHandlerTemplate Protocol to match actual
    [balance_bot.py]
2023-02-15 Add 9DOF Sensor Calibration Data get and post bot pre and post calibrating (to see if it is needed)
2023-02-15 In bb_bno055_sensor, fix shebang line, doc string and reorder imports
    [bb_bno055_sensor.py]
2023-02-16 Added stdout listener and subscribed BNO055_sensor to monitor calibration for testing
2023-02-16 Updated 9DOF sensor event handler name to "logfile" specific
2023-02-16 Change test_BNO055 to write calibration data as YAML file
2023-02-20 BNO055 Calibration Test created
2023-02-20 In BNO055 Test, Mag status index corrected from 2 to 3
    [test_BNO055_sensor.py]
2023-02-20 requirements.txt updated to best guess of current
2023-02-20 Removed check for calibrated status before reading values
2023-02-21 In bb_bno055_sensor, correct event type to "9DOF sensor"
    [bb_bno055_sensor.py]
2023-02-21 Add Inport Module Listing
    [Balance Bot Module Imports.xlsx]
2023-02-24 To robot_listener, subcribe robot movement, power handler to stdout
2023-02-24 Create Excel list of Import Dependencies
    [Balance Bot Module Imports.xlsx]
2023-02-24 Batch update os position_history files from encoder test
    [2023-01-02_23_45_12_position_history.xlsx, 2023-01-02_23_45_12_position_history_mode_summary_COBYLA.csv, 2023-01-02_23_45_12_position_history_mode_summary_COBYLA.xlsx, 2023-01-02_23_45_34_position_history.csv, 2023-01-02_23_45_34_position_history.xlsx, 2023-01-02_23_45_34_position_history_mode_summary.csv, 2023-01-02_23_45_34_position_history_mode_summary.xlsx, 2023-01-02_23_45_34_position_histor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]
2023-02-26 Minor debug updates for test_BNO055_sensor and test_robot_balance
    [bno055_calibration_config.yml]
2023-02-27 Change type hint for bno055 read_cal_data_from_file to optionally return calibration data
2023-02-27 Add missing asyncio import
    [test_robot_balance.py]
2023-02-27 Change test_robot_balance to import bno055 calibration values
2023-02-28 In test_robot_balance, change motor.min/max to motor.min_value/max_value
2023-02-28 In test sensor balance, write saved calibration values to sensor
2023-03-01 Locat updates to get test_robot_balance working - first short term balancing
    [balance_bot_config.yml, bb_bno055_sensor.py, test_BNO055_sensor.py, test_robot_balance.py]
2023-03-02 Put sensor.euler_angles into try loop, change to Box
2023-03-04 Tweaks to PID Calcs
2023-03-11 In robot_listener, correct use of dt_string, now
    [robot_listener.py]
2023-03-11 Update adafruit-circuitpython-bno055 to version 5.4.9
2023-03-23 Reconfigure project folder
    [progtest_left50-10s_right50-10s.csv, progtest_left50-2x20s_right50-2x20s.csv, progtest_leftright-100-+100x10s.csv]
2023-03-24 Restructure Code packages
    [progtest_left50-10s_right50-10s.csv, progtest_left50-2x20s_right50-2x20s.csv, progtest_leftright-100-+100x10s.csv]
2023-03-26 Event Handler to Logging Use Updates
    [progtest_left50-2x20s_right50-2x20s.csv]
2025-08-11 Electrical Connections Diagrams updated for Servos and RPi Zero
